smkilani/G-2/LVBackplane/3D/24563131.png

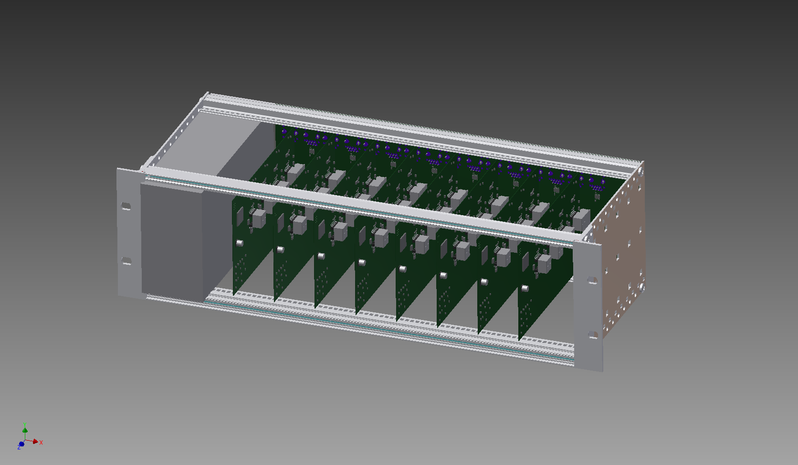
LVBackplane/3D/24563131.png
