smkilani/G-2/PCB - Rack/3d.png

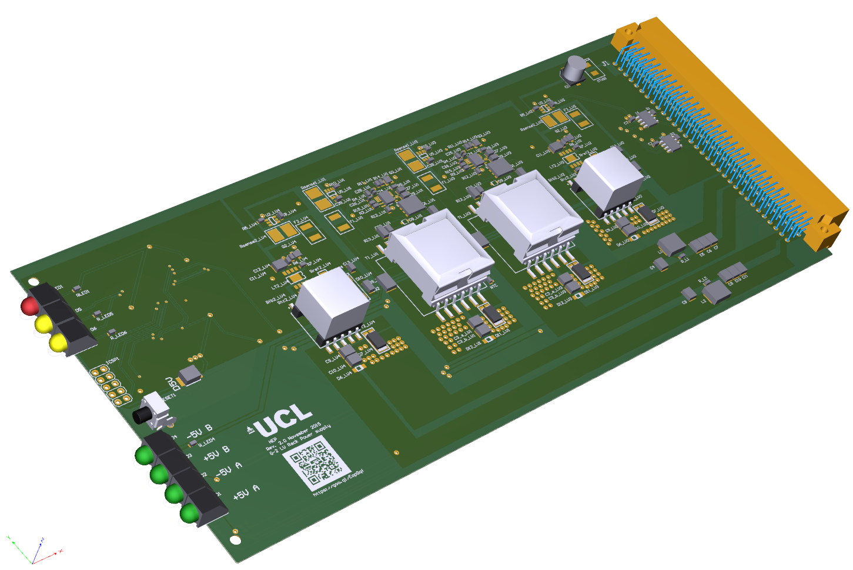
PCB - Rack/3d.png
