smkilani/G-2/PCB - Rack/ATMEL2560ref.png

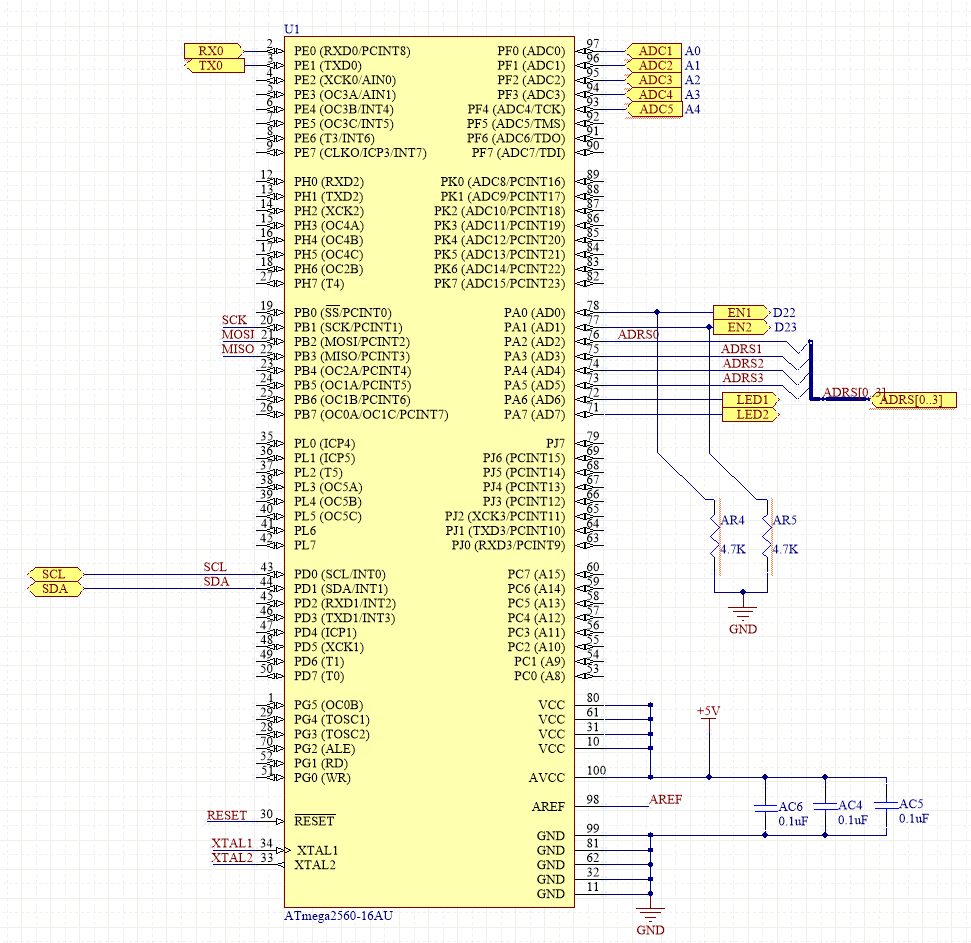
PCB - Rack/ATMEL2560ref.png
