smkilani/G-2/PCB - Rack/BOM2.xls

Designator | Footprint | Quantity | PartNo | Value
C1 | PANASONIC_D | 1 | EMZA500ADA220MF61G | 22uF
C20, C21 | PANASONIC_D | 2 | EEE1EA470WAP | 47uF
D1, D2, D3, D4 | LEDGREEN | 4 | 550-0207F
D5, D6 | LEDYELLOW | 2 | 550-0307F
ICSP1 | 2X03 | 1 | 826953-3
J1 | 09 03 164 6919 | 1
LDO1 | SOT223 | 1 | NCP1117ST50T3G
LED1 | LEDRED | 1 | 550-0407F
LED2 | CHIP-LED0805 | 1 | KPT-2012SGC
LT2_LV1, LT2_LV2, LT2_LV3, LT2_LV4 | S8E | 4 | LT8302ES8E#PBF
RESET1 | 1-1825027-4 | 1 | 1-1825027-4
U1, U2 | SOICN8 | 2 | SP3084EEN-L
U2_LV1, U2_LV2, U2_LV3, U2_LV4 | SOT-23 | 4 | INA138NA/250
Y1 | RESONATOR | 1 | CSTCE16M0V53-R0
U3 | 100A_N | 1 | ATmega2560-16AU
AC1 | 1608[0603] | 1 | CC0603KRX7R9BB104 | 22uF
AC2, AC3, AC4, AC5, AC6, C2, C3, C8_LV1, C8_LV2, C8_LV3, C8_LV4 | 1608[0603] | 11 | CC0603KRX7R9BB104 | 0.1uF
C11_LV1, C11_LV2, C11_LV3, C11_LV4 | C1210 | 4 | UMK325BJ106KM-T | 10uF
C12_LV1, C12_LV2, C12_LV3, C12_LV4 | 1608[0603] | 4 | 06033D105KAT2A | 1uF
C13_LV1, C13_LV2, C13_LV3, C13_LV4 | C0805 | 4 | 08055A221JAT2A | 470p
C30, C31, C32, C33 | 1812 | 4 | C1812C472KDRACTU | 4.7nF
C4, C8, C9_LV1, C9_LV2, C9_LV3, C9_LV4, C10_LV1, C10_LV2, C10_LV3, C10_LV4, C12, C16 | C1210 | 12 | C3225X5R0J107M250AC | 100uF
C5, C6, C7, C9, C10, C11, C13, C14, C15, C17, C18, C19 | C1210 | 12 | CL32A107MPVNNNE | 100uF
Rsense2_LV1, Rsense2_LV2, Rsense2_LV3, Rsense2_LV4 | R6432 | 4 | MCS3264R050FER | 50m
T2_LV1, T2_LV2, T2_LV3, T2_LV4 | EP13 | 4 | 750311457
F2_LV1, F2_LV2, F2_LV3, F2_LV4 | MF-MSMF1 | 4 | MF-MSMF075/24-2
F3 | MF-MSMF1 | 1 | MINISMDC050F-2
L1, L2, L3, L4 | MPLC0730 | 4 | MPLC0730L1R0 | 1uH
Q2_LV1, Q2_LV2, Q2_LV3, Q2_LV4 | SOT-23 | 4 | BSS131
D10_LV1, D10_LV2, D10_LV3, D10_LV4 | DO-214AB | 4 | ES3B
AR2, R6_LV1, R6_LV2, R6_LV3, R6_LV4 | J1-0603 | 5 |  | 1M
NTC | J1-0603 | 1 | NCP18XH103J03RB | 10K
R1, R2 | J1-0603 | 2 |  | 50R
R5_LV1, R5_LV2, R5_LV3, R5_LV4 | J1-0603 | 4 |  | 100k
R7_LV1, R7_LV2, R7_LV3, R7_LV4, Rfb2_LV1, Rfb2_LV2, Rfb2_LV3, Rfb2_LV4 | J1-0603 | 8 |  | 200k
R8_LV1, R8_LV2, R8_LV3, R8_LV4 | C1206 | 4 |  | 100R
RADRS0, RADRS1, RADRS2, RADRS3 | J1-0603 | 4 |  | 47k
RLED1 | J1-0603 | 1 |  | 1k
Rtc2_LV1, Rtc2_LV2, Rtc2_LV3, Rtc2_LV4 | J1-0603 | 4 |  | 169k
R_L1, R_L2, R_L3, R_L4 | J1-0603 | 4 |  | 1R
R_LED1, R_LED2, R_LED3, R_LED4, R_LED5, R_LED6, RLED2 | J1-0603 | 7 |  | 500R
R_NTC, R_pu5, Rref2_LV1, Rref2_LV2, Rref2_LV3, Rref2_LV4 | J1-0603 | 6 |  | 10K
R_pu1, R_pu2, R_pu3, R_pu4 | J1-0603 | 4 |  | 4.7K
D7_LV1, D7_LV2, D7_LV3, D7_LV4 | PDS1040L | 4 | PDS1040L-13
DTVS, DTVS1_LV1, DTVS1_LV2, DTVS1_LV3, DTVS1_LV4 | DO-214AA | 5 | SMBJ24A-E3/52
D6_LV1, D6_LV2, D6_LV3, D6_LV4 | SOD123F | 4 | BZT52H-B5V6
D8_LV1, D8_LV2, D8_LV3, D8_LV4 | DO-214AC | 4 | SMAJ30A
