smkilani/G-2/PCB - MasterController/LVMasterController/Project Outputs for LVMasterController/LVMasterControllerBOM.xlsx

Description | Designator | Footprint | LibRef | PartNo | Quantity | Value
Capacitor (Semiconductor SIM Model) | AC1, AC2, C1, C2, C3, C4, C5, C7, C8, C9, C10, C11, C12, C13, C14 | 1608[0603] | Cap Semi | CC0603KRX7R9BB104 | 15 | 100nF
Capacitor (Semiconductor SIM Model) | C6 | 1608[0603] | Cap Semi | CC0603KRX7R9BB104 | 1 | 33nF
 | D1, D2, D3, D4, D5, D6 | LEDYELLOW | LEDYELLOW | 550-0307F | 6
Power Diode | D7 | SMB-403A | MBRS130LT3G | MBRS130LT3G | 1
TVS | DTVS1 | DO-214AA | SMBJ | SMBJ10CA | 1
Fuse | F1 | MF-MSMF1 | Fuse 1 | MINISMDC050F-2 | 1
MICROCONTROLLER 64/128/256 Kbytes FLASH 4 Kbytes EEPROM 8 Kbytes SRAM 86 General Purpose I/O pins 12-channels16-bit PWM 4 x Serial USARTs 16-channels 10-bit A/D | IC3 | 100A_N | ATMEGA2560AU | ATMEGA2560-16AU | 1
 | ICSP1 | 2X05 | PINHD-2X5 | 2-1761605-3 | 1
 | J1 | 09 03 164 6919 | DIN41612_64WAY | 0903 164 6921 | 1
 | LDO1 | SOT223 | LDO_5V | NCP1117ST50T3G | 1
 | LED1 | LEDRED | LEDRED | 550-0407F | 1
 | P1 | EHHD006A0B41-HZ | DCDCPowerModule | EHHD006A0B41-HZ | 1
POLARIZED CAPACITOR, European symbol | PC1, PC2 | PANASONIC_D | CPOL-EUD | EEE1EA470WAP | 2
Resistor | R1, R2, R10, R11, R12, R13, R14, R17, R_pu1 | J1-0603 | Res3 |  | 9 | 10K
Resistor | R3, R_LED1, R_LED2, R_LED3, R_LED4, R_LED5, R_LED6, Rtrim_down1, Rtrim_up1 | J1-0603 | Res3 |  | 9 | 1K
Resistor | R4, R15 | J1-0603 | Res3 |  | 2 | 1M
Resistor | R5 | J1-0603 | Res3 |  | 1 | 470
Resistor | R6, R7 | J1-0603 | Res3 |  | 2 | 27
Resistor | R8 | J1-0603 | Res3 |  | 1 | 1k5
Resistor | R9 | J1-0603 | Res3 |  | 1 | 4k7
Resistor | R16 | J1-0603 | Res3 |  | 1 | 2k2
 | RESET1 | 1-1825027-4 | PB_RST | 1-1825027-4 | 1
USB UART Asynchronous Serial Data Transfer Chip, 0 to +70 degC, 32-pin LQFP, Pb-Free | U1 | LQFP-32_N | FT232BL | FT232BL | 1
 | U2, U8 | SOP65P640X120-20N | SN74LVC244APWR | SN74LVC244APWR | 2
 | U3, U4, U6, U7 | SOP65P640X120-16N | CD4051BPW | CD4051BPW | 4
 | U9 | SOP8 | SN74LVC2G32DCTR | SN74LVC2G32DCTR | 1
 | U10 | SOIC127P600X175-8N | 93LC46B-I/SN | 93LC46B-I/SN | 1
 | Y1 | RESONATOR | RESONATORMU | CSTCE16M0V53-R0 | 1
 | Y2 | CSTCR6M00G53-R0 | RESONATORMU | CSTCR6M00G53-R0 | 1
