smkilani/G-2/LVBackplane/3D/Imported Components/Backplane2/Backplane2.htm

Autodesk Inventor Translation Report | 26 June 2015 ( 14:19)
Source File: | C:\Users\smkilani\Documents\GitHub\G-2\LVBackplane\3D\Backplane2.step
Translator Type: | STEP | Sending System: | Open CASCADE 6.8
Author: | Author | Translation Time: | 00:00:08
Options
Import Type: | N/A
Entity Types to Import: | Solids, Surfaces, Wires, Points
Import into Repair Environment: | Yes
Import Assembly as Single Part: | No
Create Surfaces As: | Single Composite Feature
Check Parts during Load: | No
Auto Stitch: | No
Enable Advanced Healing: | N/A
+/- | Name | Inventor File | Status
[ ] | Backplane2.iam | C:\Users\smkilani\Documents\GitHub\G-2\LVBackplane\3D\Imported Components\Backplane2\Backplane2.iam | Successful
[ ] | Board.ipt | C:\Users\smkilani\Documents\GitHub\G-2\LVBackplane\3D\Imported Components\Backplane2\Board.ipt | Successful
[ ] | DB1_9.iam | C:\Users\smkilani\Documents\GitHub\G-2\LVBackplane\3D\Imported Components\Backplane2\DB1_9.iam | Successful
[+] [-] | 172-009-212.ipt | C:\Users\smkilani\Documents\GitHub\G-2\LVBackplane\3D\Imported Components\Backplane2\172-009-212.ipt | Warning
Severity | Entity Id | Message
Warning | 98852 | Some Surfaces have been simplified
[ ] | DB2_9.iam | C:\Users\smkilani\Documents\GitHub\G-2\LVBackplane\3D\Imported Components\Backplane2\DB2_9.iam | Successful
[ ] | RJ1_9.iam | C:\Users\smkilani\Documents\GitHub\G-2\LVBackplane\3D\Imported Components\Backplane2\RJ1_9.iam | Successful
[ ] | 424108312.iam | C:\Users\smkilani\Documents\GitHub\G-2\LVBackplane\3D\Imported Components\Backplane2\424108312.iam | Successful
[ ] | Open CASCADE STEP translator 6.8 6.4.1.1.ipt | C:\Users\smkilani\Documents\GitHub\G-2\LVBackplane\3D\Imported Components\Backplane2\Open CASCADE STEP translator 6.8 6.4.1.1.ipt | Successful
[ ] | Open CASCADE STEP translator 6.8 6.4.1.2.ipt | C:\Users\smkilani\Documents\GitHub\G-2\LVBackplane\3D\Imported Components\Backplane2\Open CASCADE STEP translator 6.8 6.4.1.2.ipt | Successful
[ ] | RJ2_9.iam | C:\Users\smkilani\Documents\GitHub\G-2\LVBackplane\3D\Imported Components\Backplane2\RJ2_9.iam | Successful
[ ] | J1_9.iam | C:\Users\smkilani\Documents\GitHub\G-2\LVBackplane\3D\Imported Components\Backplane2\J1_9.iam | Successful
[ ] | EDAC-307-044-520-202.iam | C:\Users\smkilani\Documents\GitHub\G-2\LVBackplane\3D\Imported Components\Backplane2\EDAC-307-044-520-202.iam | Successful
[ ] | EDAC-307-044-520-202_307_Part_.128_Dia_Mounting_Holes.ipt | C:\Users\smkilani\Documents\GitHub\G-2\LVBackplane\3D\Imported Components\Backplane2\EDAC-307-044-520-202_307_Part_.128_Dia_Mounting_Holes.ipt | Successful
[ ] | EDAC-307-044-520-202_307-290-001_520.ipt | C:\Users\smkilani\Documents\GitHub\G-2\LVBackplane\3D\Imported Components\Backplane2\EDAC-307-044-520-202_307-290-001_520.ipt | Successful
[ ] | DB1_8.iam | C:\Users\smkilani\Documents\GitHub\G-2\LVBackplane\3D\Imported Components\Backplane2\DB1_8.iam | Successful
[ ] | DB2_8.iam | C:\Users\smkilani\Documents\GitHub\G-2\LVBackplane\3D\Imported Components\Backplane2\DB2_8.iam | Successful
[ ] | RJ1_8.iam | C:\Users\smkilani\Documents\GitHub\G-2\LVBackplane\3D\Imported Components\Backplane2\RJ1_8.iam | Successful
[ ] | RJ2_8.iam | C:\Users\smkilani\Documents\GitHub\G-2\LVBackplane\3D\Imported Components\Backplane2\RJ2_8.iam | Successful
[ ] | J1_8.iam | C:\Users\smkilani\Documents\GitHub\G-2\LVBackplane\3D\Imported Components\Backplane2\J1_8.iam | Successful
[ ] | DB1_7.iam | C:\Users\smkilani\Documents\GitHub\G-2\LVBackplane\3D\Imported Components\Backplane2\DB1_7.iam | Successful
[ ] | DB2_7.iam | C:\Users\smkilani\Documents\GitHub\G-2\LVBackplane\3D\Imported Components\Backplane2\DB2_7.iam | Successful
[ ] | RJ1_7.iam | C:\Users\smkilani\Documents\GitHub\G-2\LVBackplane\3D\Imported Components\Backplane2\RJ1_7.iam | Successful
[ ] | RJ2_7.iam | C:\Users\smkilani\Documents\GitHub\G-2\LVBackplane\3D\Imported Components\Backplane2\RJ2_7.iam | Successful
[ ] | J1_7.iam | C:\Users\smkilani\Documents\GitHub\G-2\LVBackplane\3D\Imported Components\Backplane2\J1_7.iam | Successful
[ ] | DB1_6.iam | C:\Users\smkilani\Documents\GitHub\G-2\LVBackplane\3D\Imported Components\Backplane2\DB1_6.iam | Successful
[ ] | DB2_6.iam | C:\Users\smkilani\Documents\GitHub\G-2\LVBackplane\3D\Imported Components\Backplane2\DB2_6.iam | Successful
[ ] | RJ1_6.iam | C:\Users\smkilani\Documents\GitHub\G-2\LVBackplane\3D\Imported Components\Backplane2\RJ1_6.iam | Successful
[ ] | RJ2_6.iam | C:\Users\smkilani\Documents\GitHub\G-2\LVBackplane\3D\Imported Components\Backplane2\RJ2_6.iam | Successful
[ ] | J1_6.iam | C:\Users\smkilani\Documents\GitHub\G-2\LVBackplane\3D\Imported Components\Backplane2\J1_6.iam | Successful
[ ] | DB1_5.iam | C:\Users\smkilani\Documents\GitHub\G-2\LVBackplane\3D\Imported Components\Backplane2\DB1_5.iam | Successful
[ ] | DB2_5.iam | C:\Users\smkilani\Documents\GitHub\G-2\LVBackplane\3D\Imported Components\Backplane2\DB2_5.iam | Successful
[ ] | RJ1_5.iam | C:\Users\smkilani\Documents\GitHub\G-2\LVBackplane\3D\Imported Components\Backplane2\RJ1_5.iam | Successful
[ ] | RJ2_5.iam | C:\Users\smkilani\Documents\GitHub\G-2\LVBackplane\3D\Imported Components\Backplane2\RJ2_5.iam | Successful
[ ] | J1_5.iam | C:\Users\smkilani\Documents\GitHub\G-2\LVBackplane\3D\Imported Components\Backplane2\J1_5.iam | Successful
[ ] | DB1_4.iam | C:\Users\smkilani\Documents\GitHub\G-2\LVBackplane\3D\Imported Components\Backplane2\DB1_4.iam | Successful
[ ] | DB2_4.iam | C:\Users\smkilani\Documents\GitHub\G-2\LVBackplane\3D\Imported Components\Backplane2\DB2_4.iam | Successful
[ ] | RJ1_4.iam | C:\Users\smkilani\Documents\GitHub\G-2\LVBackplane\3D\Imported Components\Backplane2\RJ1_4.iam | Successful
[ ] | RJ2_4.iam | C:\Users\smkilani\Documents\GitHub\G-2\LVBackplane\3D\Imported Components\Backplane2\RJ2_4.iam | Successful
[ ] | J1_4.iam | C:\Users\smkilani\Documents\GitHub\G-2\LVBackplane\3D\Imported Components\Backplane2\J1_4.iam | Successful
[ ] | DB1_3.iam | C:\Users\smkilani\Documents\GitHub\G-2\LVBackplane\3D\Imported Components\Backplane2\DB1_3.iam | Successful
[ ] | DB2_3.iam | C:\Users\smkilani\Documents\GitHub\G-2\LVBackplane\3D\Imported Components\Backplane2\DB2_3.iam | Successful
[ ] | RJ1_3.iam | C:\Users\smkilani\Documents\GitHub\G-2\LVBackplane\3D\Imported Components\Backplane2\RJ1_3.iam | Successful
[ ] | RJ2_3.iam | C:\Users\smkilani\Documents\GitHub\G-2\LVBackplane\3D\Imported Components\Backplane2\RJ2_3.iam | Successful
[ ] | J1_3.iam | C:\Users\smkilani\Documents\GitHub\G-2\LVBackplane\3D\Imported Components\Backplane2\J1_3.iam | Successful
[ ] | DB1_2.iam | C:\Users\smkilani\Documents\GitHub\G-2\LVBackplane\3D\Imported Components\Backplane2\DB1_2.iam | Successful
[ ] | DB2_2.iam | C:\Users\smkilani\Documents\GitHub\G-2\LVBackplane\3D\Imported Components\Backplane2\DB2_2.iam | Successful
[ ] | RJ1_2.iam | C:\Users\smkilani\Documents\GitHub\G-2\LVBackplane\3D\Imported Components\Backplane2\RJ1_2.iam | Successful
[ ] | RJ2_2.iam | C:\Users\smkilani\Documents\GitHub\G-2\LVBackplane\3D\Imported Components\Backplane2\RJ2_2.iam | Successful
[ ] | J1_2.iam | C:\Users\smkilani\Documents\GitHub\G-2\LVBackplane\3D\Imported Components\Backplane2\J1_2.iam | Successful
[ ] | DB1_1.iam | C:\Users\smkilani\Documents\GitHub\G-2\LVBackplane\3D\Imported Components\Backplane2\DB1_1.iam | Successful
[ ] | DB2_1.iam | C:\Users\smkilani\Documents\GitHub\G-2\LVBackplane\3D\Imported Components\Backplane2\DB2_1.iam | Successful
[ ] | RJ1_1.iam | C:\Users\smkilani\Documents\GitHub\G-2\LVBackplane\3D\Imported Components\Backplane2\RJ1_1.iam | Successful
[ ] | RJ2_1.iam | C:\Users\smkilani\Documents\GitHub\G-2\LVBackplane\3D\Imported Components\Backplane2\RJ2_1.iam | Successful
[ ] | J1_1.iam | C:\Users\smkilani\Documents\GitHub\G-2\LVBackplane\3D\Imported Components\Backplane2\J1_1.iam | Successful
[ ] | J1.iam | C:\Users\smkilani\Documents\GitHub\G-2\LVBackplane\3D\Imported Components\Backplane2\J1.iam | Successful
[ ] | J1_controller.iam | C:\Users\smkilani\Documents\GitHub\G-2\LVBackplane\3D\Imported Components\Backplane2\J1_controller.iam | Successful
[ ] | RJ2.iam | C:\Users\smkilani\Documents\GitHub\G-2\LVBackplane\3D\Imported Components\Backplane2\RJ2.iam | Successful
[ ] | RJ1.iam | C:\Users\smkilani\Documents\GitHub\G-2\LVBackplane\3D\Imported Components\Backplane2\RJ1.iam | Successful
[ ] | DB2.iam | C:\Users\smkilani\Documents\GitHub\G-2\LVBackplane\3D\Imported Components\Backplane2\DB2.iam | Successful
[ ] | DB1.iam | C:\Users\smkilani\Documents\GitHub\G-2\LVBackplane\3D\Imported Components\Backplane2\DB1.iam | Successful
