smkilani/G-2/LVBackplane/3D/Imported Components/LV1/LV1.htm

Autodesk Inventor Translation Report | 26 June 2015 ( 16:13)
Source File: | C:\Users\smkilani\Documents\GitHub\G-2\LVBackplane\3D\LV1.step
Translator Type: | STEP | Sending System: | Open CASCADE 6.8
Author: | Author | Translation Time: | 00:00:05
Options
Import Type: | N/A
Entity Types to Import: | Solids, Surfaces, Wires, Points
Import into Repair Environment: | Yes
Import Assembly as Single Part: | No
Create Surfaces As: | Single Composite Feature
Check Parts during Load: | No
Auto Stitch: | No
Enable Advanced Healing: | N/A
+/- | Name | Inventor File | Status
[ ] | LV1.iam | C:\Users\smkilani\Documents\GitHub\G-2\LVBackplane\3D\Imported Components\LV1\LV1.iam | Successful
[ ] | Board.ipt | C:\Users\smkilani\Documents\GitHub\G-2\LVBackplane\3D\Imported Components\LV1\Board.ipt | Successful
[ ] | U2.iam | C:\Users\smkilani\Documents\GitHub\G-2\LVBackplane\3D\Imported Components\LV1\U2.iam | Successful
[ ] | 574394112.iam | C:\Users\smkilani\Documents\GitHub\G-2\LVBackplane\3D\Imported Components\LV1\574394112.iam | Successful
[ ] | Extruded.ipt | C:\Users\smkilani\Documents\GitHub\G-2\LVBackplane\3D\Imported Components\LV1\Extruded.ipt | Successful
[ ] | 574394272.iam | C:\Users\smkilani\Documents\GitHub\G-2\LVBackplane\3D\Imported Components\LV1\574394272.iam | Successful
[ ] | Extruded_1.ipt | C:\Users\smkilani\Documents\GitHub\G-2\LVBackplane\3D\Imported Components\LV1\Extruded_1.ipt | Successful
[ ] | U1.iam | C:\Users\smkilani\Documents\GitHub\G-2\LVBackplane\3D\Imported Components\LV1\U1.iam | Successful
[ ] | R2.iam | C:\Users\smkilani\Documents\GitHub\G-2\LVBackplane\3D\Imported Components\LV1\R2.iam | Successful
[ ] | 574386432.iam | C:\Users\smkilani\Documents\GitHub\G-2\LVBackplane\3D\Imported Components\LV1\574386432.iam | Successful
[ ] | Extruded_2.ipt | C:\Users\smkilani\Documents\GitHub\G-2\LVBackplane\3D\Imported Components\LV1\Extruded_2.ipt | Successful
[ ] | R1.iam | C:\Users\smkilani\Documents\GitHub\G-2\LVBackplane\3D\Imported Components\LV1\R1.iam | Successful
[ ] | C3.iam | C:\Users\smkilani\Documents\GitHub\G-2\LVBackplane\3D\Imported Components\LV1\C3.iam | Successful
[ ] | 574386752.iam | C:\Users\smkilani\Documents\GitHub\G-2\LVBackplane\3D\Imported Components\LV1\574386752.iam | Successful
[ ] | Extruded_3.ipt | C:\Users\smkilani\Documents\GitHub\G-2\LVBackplane\3D\Imported Components\LV1\Extruded_3.ipt | Successful
[ ] | C2.iam | C:\Users\smkilani\Documents\GitHub\G-2\LVBackplane\3D\Imported Components\LV1\C2.iam | Successful
[ ] | U_.iam | C:\Users\smkilani\Documents\GitHub\G-2\LVBackplane\3D\Imported Components\LV1\U_.iam | Successful
[ ] | 853979200.iam | C:\Users\smkilani\Documents\GitHub\G-2\LVBackplane\3D\Imported Components\LV1\853979200.iam | Successful
[ ] | Extruded_4.ipt | C:\Users\smkilani\Documents\GitHub\G-2\LVBackplane\3D\Imported Components\LV1\Extruded_4.ipt | Successful
[ ] | RLED2.iam | C:\Users\smkilani\Documents\GitHub\G-2\LVBackplane\3D\Imported Components\LV1\RLED2.iam | Successful
[ ] | 574386272.iam | C:\Users\smkilani\Documents\GitHub\G-2\LVBackplane\3D\Imported Components\LV1\574386272.iam | Successful
[ ] | Extruded_5.ipt | C:\Users\smkilani\Documents\GitHub\G-2\LVBackplane\3D\Imported Components\LV1\Extruded_5.ipt | Successful
[ ] | RLED1.iam | C:\Users\smkilani\Documents\GitHub\G-2\LVBackplane\3D\Imported Components\LV1\RLED1.iam | Successful
[ ] | R_pu4.iam | C:\Users\smkilani\Documents\GitHub\G-2\LVBackplane\3D\Imported Components\LV1\R_pu4.iam | Successful
[ ] | R_pu3.iam | C:\Users\smkilani\Documents\GitHub\G-2\LVBackplane\3D\Imported Components\LV1\R_pu3.iam | Successful
[ ] | R_pu2.iam | C:\Users\smkilani\Documents\GitHub\G-2\LVBackplane\3D\Imported Components\LV1\R_pu2.iam | Successful
[ ] | R_pu1.iam | C:\Users\smkilani\Documents\GitHub\G-2\LVBackplane\3D\Imported Components\LV1\R_pu1.iam | Successful
[ ] | R_NTC.iam | C:\Users\smkilani\Documents\GitHub\G-2\LVBackplane\3D\Imported Components\LV1\R_NTC.iam | Successful
[ ] | NTC.iam | C:\Users\smkilani\Documents\GitHub\G-2\LVBackplane\3D\Imported Components\LV1\NTC.iam | Successful
[ ] | C1.iam | C:\Users\smkilani\Documents\GitHub\G-2\LVBackplane\3D\Imported Components\LV1\C1.iam | Successful
[ ] | 578375272.iam | C:\Users\smkilani\Documents\GitHub\G-2\LVBackplane\3D\Imported Components\LV1\578375272.iam | Successful
[ ] | Cylinder.ipt | C:\Users\smkilani\Documents\GitHub\G-2\LVBackplane\3D\Imported Components\LV1\Cylinder.ipt | Successful
[ ] | 574395072.iam | C:\Users\smkilani\Documents\GitHub\G-2\LVBackplane\3D\Imported Components\LV1\574395072.iam | Successful
[ ] | Extruded_6.ipt | C:\Users\smkilani\Documents\GitHub\G-2\LVBackplane\3D\Imported Components\LV1\Extruded_6.ipt | Successful
[ ] | AR2.iam | C:\Users\smkilani\Documents\GitHub\G-2\LVBackplane\3D\Imported Components\LV1\AR2.iam | Successful
[ ] | AC5.iam | C:\Users\smkilani\Documents\GitHub\G-2\LVBackplane\3D\Imported Components\LV1\AC5.iam | Successful
[ ] | 574387872.iam | C:\Users\smkilani\Documents\GitHub\G-2\LVBackplane\3D\Imported Components\LV1\574387872.iam | Successful
[ ] | Extruded_7.ipt | C:\Users\smkilani\Documents\GitHub\G-2\LVBackplane\3D\Imported Components\LV1\Extruded_7.ipt | Successful
[ ] | AC4.iam | C:\Users\smkilani\Documents\GitHub\G-2\LVBackplane\3D\Imported Components\LV1\AC4.iam | Successful
[ ] | AC3.iam | C:\Users\smkilani\Documents\GitHub\G-2\LVBackplane\3D\Imported Components\LV1\AC3.iam | Successful
[ ] | AC2.iam | C:\Users\smkilani\Documents\GitHub\G-2\LVBackplane\3D\Imported Components\LV1\AC2.iam | Successful
[ ] | AC1.iam | C:\Users\smkilani\Documents\GitHub\G-2\LVBackplane\3D\Imported Components\LV1\AC1.iam | Successful
[ ] | C11_LV4.iam | C:\Users\smkilani\Documents\GitHub\G-2\LVBackplane\3D\Imported Components\LV1\C11_LV4.iam | Successful
[ ] | 574393952.iam | C:\Users\smkilani\Documents\GitHub\G-2\LVBackplane\3D\Imported Components\LV1\574393952.iam | Successful
[ ] | Extruded_8.ipt | C:\Users\smkilani\Documents\GitHub\G-2\LVBackplane\3D\Imported Components\LV1\Extruded_8.ipt | Successful
[ ] | Rtc2_LV4.iam | C:\Users\smkilani\Documents\GitHub\G-2\LVBackplane\3D\Imported Components\LV1\Rtc2_LV4.iam | Successful
[ ] | R7_LV4.iam | C:\Users\smkilani\Documents\GitHub\G-2\LVBackplane\3D\Imported Components\LV1\R7_LV4.iam | Successful
[ ] | R6_LV4.iam | C:\Users\smkilani\Documents\GitHub\G-2\LVBackplane\3D\Imported Components\LV1\R6_LV4.iam | Successful
[ ] | Q2_LV4.iam | C:\Users\smkilani\Documents\GitHub\G-2\LVBackplane\3D\Imported Components\LV1\Q2_LV4.iam | Successful
[ ] | 923694272.iam | C:\Users\smkilani\Documents\GitHub\G-2\LVBackplane\3D\Imported Components\LV1\923694272.iam | Successful
[ ] | Extruded_9.ipt | C:\Users\smkilani\Documents\GitHub\G-2\LVBackplane\3D\Imported Components\LV1\Extruded_9.ipt | Successful
[ ] | R8_LV4.iam | C:\Users\smkilani\Documents\GitHub\G-2\LVBackplane\3D\Imported Components\LV1\R8_LV4.iam | Successful
[ ] | 923694912.iam | C:\Users\smkilani\Documents\GitHub\G-2\LVBackplane\3D\Imported Components\LV1\923694912.iam | Successful
[ ] | Extruded_10.ipt | C:\Users\smkilani\Documents\GitHub\G-2\LVBackplane\3D\Imported Components\LV1\Extruded_10.ipt | Successful
[ ] | C30_LV4.iam | C:\Users\smkilani\Documents\GitHub\G-2\LVBackplane\3D\Imported Components\LV1\C30_LV4.iam | Successful
[ ] | 923695072.iam | C:\Users\smkilani\Documents\GitHub\G-2\LVBackplane\3D\Imported Components\LV1\923695072.iam | Successful
[ ] | Extruded_11.ipt | C:\Users\smkilani\Documents\GitHub\G-2\LVBackplane\3D\Imported Components\LV1\Extruded_11.ipt | Successful
[ ] | T2_LV4.iam | C:\Users\smkilani\Documents\GitHub\G-2\LVBackplane\3D\Imported Components\LV1\T2_LV4.iam | Successful
[ ] | WE-FB_EP13.iam | C:\Users\smkilani\Documents\GitHub\G-2\LVBackplane\3D\Imported Components\LV1\WE-FB_EP13.iam | Successful
[ ] | Gehäuse.ipt | C:\Users\smkilani\Documents\GitHub\G-2\LVBackplane\3D\Imported Components\LV1\Gehäuse.ipt | Successful
[ ] | Core_EP-13.ipt | C:\Users\smkilani\Documents\GitHub\G-2\LVBackplane\3D\Imported Components\LV1\Core_EP-13.ipt | Successful
[ ] | C9_LV4.iam | C:\Users\smkilani\Documents\GitHub\G-2\LVBackplane\3D\Imported Components\LV1\C9_LV4.iam | Successful
[ ] | Rref2_LV4.iam | C:\Users\smkilani\Documents\GitHub\G-2\LVBackplane\3D\Imported Components\LV1\Rref2_LV4.iam | Successful
[ ] | R5_LV4.iam | C:\Users\smkilani\Documents\GitHub\G-2\LVBackplane\3D\Imported Components\LV1\R5_LV4.iam | Successful
[ ] | D7_LV4.iam | C:\Users\smkilani\Documents\GitHub\G-2\LVBackplane\3D\Imported Components\LV1\D7_LV4.iam | Successful
[ ] | 574394592.iam | C:\Users\smkilani\Documents\GitHub\G-2\LVBackplane\3D\Imported Components\LV1\574394592.iam | Successful
[ ] | Extruded_12.ipt | C:\Users\smkilani\Documents\GitHub\G-2\LVBackplane\3D\Imported Components\LV1\Extruded_12.ipt | Successful
[ ] | 574394752.iam | C:\Users\smkilani\Documents\GitHub\G-2\LVBackplane\3D\Imported Components\LV1\574394752.iam | Successful
[ ] | Extruded_13.ipt | C:\Users\smkilani\Documents\GitHub\G-2\LVBackplane\3D\Imported Components\LV1\Extruded_13.ipt | Successful
[ ] | 574394912.iam | C:\Users\smkilani\Documents\GitHub\G-2\LVBackplane\3D\Imported Components\LV1\574394912.iam | Successful
[ ] | Extruded_14.ipt | C:\Users\smkilani\Documents\GitHub\G-2\LVBackplane\3D\Imported Components\LV1\Extruded_14.ipt | Successful
[ ] | C13_LV4.iam | C:\Users\smkilani\Documents\GitHub\G-2\LVBackplane\3D\Imported Components\LV1\C13_LV4.iam | Successful
[ ] | 923695392.iam | C:\Users\smkilani\Documents\GitHub\G-2\LVBackplane\3D\Imported Components\LV1\923695392.iam | Successful
[ ] | Extruded_15.ipt | C:\Users\smkilani\Documents\GitHub\G-2\LVBackplane\3D\Imported Components\LV1\Extruded_15.ipt | Successful
[ ] | C10_LV4.iam | C:\Users\smkilani\Documents\GitHub\G-2\LVBackplane\3D\Imported Components\LV1\C10_LV4.iam | Successful
[ ] | Rfb2_LV4.iam | C:\Users\smkilani\Documents\GitHub\G-2\LVBackplane\3D\Imported Components\LV1\Rfb2_LV4.iam | Successful
[ ] | C12_LV4.iam | C:\Users\smkilani\Documents\GitHub\G-2\LVBackplane\3D\Imported Components\LV1\C12_LV4.iam | Successful
[ ] | C8_LV4.iam | C:\Users\smkilani\Documents\GitHub\G-2\LVBackplane\3D\Imported Components\LV1\C8_LV4.iam | Successful
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
[ ] | C12_LV1.iam | C:\Users\smkilani\Documents\GitHub\G-2\LVBackplane\3D\Imported Components\LV1\C12_LV1.iam | Successful
[ ] | Rfb2_LV1.iam | C:\Users\smkilani\Documents\GitHub\G-2\LVBackplane\3D\Imported Components\LV1\Rfb2_LV1.iam | Successful
[ ] | C10_LV1.iam | C:\Users\smkilani\Documents\GitHub\G-2\LVBackplane\3D\Imported Components\LV1\C10_LV1.iam | Successful
[ ] | C13_LV1.iam | C:\Users\smkilani\Documents\GitHub\G-2\LVBackplane\3D\Imported Components\LV1\C13_LV1.iam | Successful
[ ] | D7_LV1.iam | C:\Users\smkilani\Documents\GitHub\G-2\LVBackplane\3D\Imported Components\LV1\D7_LV1.iam | Successful
[ ] | R5_LV1.iam | C:\Users\smkilani\Documents\GitHub\G-2\LVBackplane\3D\Imported Components\LV1\R5_LV1.iam | Successful
[ ] | Rref2_LV1.iam | C:\Users\smkilani\Documents\GitHub\G-2\LVBackplane\3D\Imported Components\LV1\Rref2_LV1.iam | Successful
[ ] | C9_LV1.iam | C:\Users\smkilani\Documents\GitHub\G-2\LVBackplane\3D\Imported Components\LV1\C9_LV1.iam | Successful
[ ] | T2_LV1.iam | C:\Users\smkilani\Documents\GitHub\G-2\LVBackplane\3D\Imported Components\LV1\T2_LV1.iam | Successful
[ ] | C30_LV1.iam | C:\Users\smkilani\Documents\GitHub\G-2\LVBackplane\3D\Imported Components\LV1\C30_LV1.iam | Successful
[ ] | R8_LV1.iam | C:\Users\smkilani\Documents\GitHub\G-2\LVBackplane\3D\Imported Components\LV1\R8_LV1.iam | Successful
[ ] | Q2_LV1.iam | C:\Users\smkilani\Documents\GitHub\G-2\LVBackplane\3D\Imported Components\LV1\Q2_LV1.iam | Successful
[ ] | R6_LV1.iam | C:\Users\smkilani\Documents\GitHub\G-2\LVBackplane\3D\Imported Components\LV1\R6_LV1.iam | Successful
[ ] | R7_LV1.iam | C:\Users\smkilani\Documents\GitHub\G-2\LVBackplane\3D\Imported Components\LV1\R7_LV1.iam | Successful
[ ] | Rtc2_LV1.iam | C:\Users\smkilani\Documents\GitHub\G-2\LVBackplane\3D\Imported Components\LV1\Rtc2_LV1.iam | Successful
[ ] | C11_LV1.iam | C:\Users\smkilani\Documents\GitHub\G-2\LVBackplane\3D\Imported Components\LV1\C11_LV1.iam | Successful
