smkilani/G-2/LVBackplane/3D/Imported Components/Backplane/Backplane.htm

Autodesk Inventor Translation Report | 23 June 2015 ( 15:08)
Source File: | C:\Users\smkilani\Documents\GitHub\G-2\LVBackplane\3D\Backplane.step
Translator Type: | STEP | Sending System: | Open CASCADE 6.8
Author: | Author | Translation Time: | 00:00:09
Options
Import Type: | N/A
Entity Types to Import: | Solids, Surfaces, Wires, Points
Import into Repair Environment: | Yes
Import Assembly as Single Part: | No
Create Surfaces As: | Single Composite Feature
Check Parts during Load: | No
Auto Stitch: | No
Enable Advanced Healing: | N/A
+/- | Name | Inventor File | Status
[ ] | Backplane.iam | C:\Users\smkilani\Documents\GitHub\G-2\LVBackplane\3D\Imported Components\Backplane\Backplane.iam | Successful
[ ] | Board.ipt | C:\Users\smkilani\Documents\GitHub\G-2\LVBackplane\3D\Imported Components\Backplane\Board.ipt | Successful
[ ] | U2_U8.iam | C:\Users\smkilani\Documents\GitHub\G-2\LVBackplane\3D\Imported Components\Backplane\U2_U8.iam | Successful
[ ] | 574400032.iam | C:\Users\smkilani\Documents\GitHub\G-2\LVBackplane\3D\Imported Components\Backplane\574400032.iam | Successful
[ ] | Extruded.ipt | C:\Users\smkilani\Documents\GitHub\G-2\LVBackplane\3D\Imported Components\Backplane\Extruded.ipt | Successful
[ ] | 574400192.iam | C:\Users\smkilani\Documents\GitHub\G-2\LVBackplane\3D\Imported Components\Backplane\574400192.iam | Successful
[ ] | Extruded_1.ipt | C:\Users\smkilani\Documents\GitHub\G-2\LVBackplane\3D\Imported Components\Backplane\Extruded_1.ipt | Successful
[ ] | U1_U8.iam | C:\Users\smkilani\Documents\GitHub\G-2\LVBackplane\3D\Imported Components\Backplane\U1_U8.iam | Successful
[ ] | RJ2_U8.iam | C:\Users\smkilani\Documents\GitHub\G-2\LVBackplane\3D\Imported Components\Backplane\RJ2_U8.iam | Successful
[ ] | 424108312.iam | C:\Users\smkilani\Documents\GitHub\G-2\LVBackplane\3D\Imported Components\Backplane\424108312.iam | Successful
[ ] | Open CASCADE STEP translator 6.8 4.4.1.1.ipt | C:\Users\smkilani\Documents\GitHub\G-2\LVBackplane\3D\Imported Components\Backplane\Open CASCADE STEP translator 6.8 4.4.1.1.ipt | Successful
[ ] | Open CASCADE STEP translator 6.8 4.4.1.2.ipt | C:\Users\smkilani\Documents\GitHub\G-2\LVBackplane\3D\Imported Components\Backplane\Open CASCADE STEP translator 6.8 4.4.1.2.ipt | Successful
[ ] | RJ1_U8.iam | C:\Users\smkilani\Documents\GitHub\G-2\LVBackplane\3D\Imported Components\Backplane\RJ1_U8.iam | Successful
[ ] | R2_U8.iam | C:\Users\smkilani\Documents\GitHub\G-2\LVBackplane\3D\Imported Components\Backplane\R2_U8.iam | Successful
[ ] | 574386432.iam | C:\Users\smkilani\Documents\GitHub\G-2\LVBackplane\3D\Imported Components\Backplane\574386432.iam | Successful
[ ] | Extruded_2.ipt | C:\Users\smkilani\Documents\GitHub\G-2\LVBackplane\3D\Imported Components\Backplane\Extruded_2.ipt | Successful
[ ] | R1_U8.iam | C:\Users\smkilani\Documents\GitHub\G-2\LVBackplane\3D\Imported Components\Backplane\R1_U8.iam | Successful
[ ] | DB2_U8.iam | C:\Users\smkilani\Documents\GitHub\G-2\LVBackplane\3D\Imported Components\Backplane\DB2_U8.iam | Successful
[+] [-] | 172-009-212.ipt | C:\Users\smkilani\Documents\GitHub\G-2\LVBackplane\3D\Imported Components\Backplane\172-009-212.ipt | Warning
Severity | Entity Id | Message
Warning | 104482 | Some Surfaces have been simplified
[ ] | DB1_U8.iam | C:\Users\smkilani\Documents\GitHub\G-2\LVBackplane\3D\Imported Components\Backplane\DB1_U8.iam | Successful
[ ] | C2_U8.iam | C:\Users\smkilani\Documents\GitHub\G-2\LVBackplane\3D\Imported Components\Backplane\C2_U8.iam | Successful
[ ] | 574387872.iam | C:\Users\smkilani\Documents\GitHub\G-2\LVBackplane\3D\Imported Components\Backplane\574387872.iam | Successful
[ ] | Extruded_3.ipt | C:\Users\smkilani\Documents\GitHub\G-2\LVBackplane\3D\Imported Components\Backplane\Extruded_3.ipt | Successful
[ ] | C1_U8.iam | C:\Users\smkilani\Documents\GitHub\G-2\LVBackplane\3D\Imported Components\Backplane\C1_U8.iam | Successful
[ ] | J1_U8.iam | C:\Users\smkilani\Documents\GitHub\G-2\LVBackplane\3D\Imported Components\Backplane\J1_U8.iam | Successful
[ ] | 10046971004lf.ipt | C:\Users\smkilani\Documents\GitHub\G-2\LVBackplane\3D\Imported Components\Backplane\10046971004lf.ipt | Successful
[ ] | J1_U5.iam | C:\Users\smkilani\Documents\GitHub\G-2\LVBackplane\3D\Imported Components\Backplane\J1_U5.iam | Successful
[ ] | C1_U5.iam | C:\Users\smkilani\Documents\GitHub\G-2\LVBackplane\3D\Imported Components\Backplane\C1_U5.iam | Successful
[ ] | C2_U5.iam | C:\Users\smkilani\Documents\GitHub\G-2\LVBackplane\3D\Imported Components\Backplane\C2_U5.iam | Successful
[ ] | DB1_U5.iam | C:\Users\smkilani\Documents\GitHub\G-2\LVBackplane\3D\Imported Components\Backplane\DB1_U5.iam | Successful
[ ] | DB2_U5.iam | C:\Users\smkilani\Documents\GitHub\G-2\LVBackplane\3D\Imported Components\Backplane\DB2_U5.iam | Successful
[ ] | R1_U5.iam | C:\Users\smkilani\Documents\GitHub\G-2\LVBackplane\3D\Imported Components\Backplane\R1_U5.iam | Successful
[ ] | R2_U5.iam | C:\Users\smkilani\Documents\GitHub\G-2\LVBackplane\3D\Imported Components\Backplane\R2_U5.iam | Successful
[ ] | RJ1_U5.iam | C:\Users\smkilani\Documents\GitHub\G-2\LVBackplane\3D\Imported Components\Backplane\RJ1_U5.iam | Successful
[ ] | RJ2_U5.iam | C:\Users\smkilani\Documents\GitHub\G-2\LVBackplane\3D\Imported Components\Backplane\RJ2_U5.iam | Successful
[ ] | U1_U5.iam | C:\Users\smkilani\Documents\GitHub\G-2\LVBackplane\3D\Imported Components\Backplane\U1_U5.iam | Successful
[ ] | U2_U5.iam | C:\Users\smkilani\Documents\GitHub\G-2\LVBackplane\3D\Imported Components\Backplane\U2_U5.iam | Successful
[ ] | U2_U7.iam | C:\Users\smkilani\Documents\GitHub\G-2\LVBackplane\3D\Imported Components\Backplane\U2_U7.iam | Successful
[ ] | U1_U7.iam | C:\Users\smkilani\Documents\GitHub\G-2\LVBackplane\3D\Imported Components\Backplane\U1_U7.iam | Successful
[ ] | RJ2_U7.iam | C:\Users\smkilani\Documents\GitHub\G-2\LVBackplane\3D\Imported Components\Backplane\RJ2_U7.iam | Successful
[ ] | RJ1_U7.iam | C:\Users\smkilani\Documents\GitHub\G-2\LVBackplane\3D\Imported Components\Backplane\RJ1_U7.iam | Successful
[ ] | R2_U7.iam | C:\Users\smkilani\Documents\GitHub\G-2\LVBackplane\3D\Imported Components\Backplane\R2_U7.iam | Successful
[ ] | R1_U7.iam | C:\Users\smkilani\Documents\GitHub\G-2\LVBackplane\3D\Imported Components\Backplane\R1_U7.iam | Successful
[ ] | DB2_U7.iam | C:\Users\smkilani\Documents\GitHub\G-2\LVBackplane\3D\Imported Components\Backplane\DB2_U7.iam | Successful
[ ] | DB1_U7.iam | C:\Users\smkilani\Documents\GitHub\G-2\LVBackplane\3D\Imported Components\Backplane\DB1_U7.iam | Successful
[ ] | C2_U7.iam | C:\Users\smkilani\Documents\GitHub\G-2\LVBackplane\3D\Imported Components\Backplane\C2_U7.iam | Successful
[ ] | C1_U7.iam | C:\Users\smkilani\Documents\GitHub\G-2\LVBackplane\3D\Imported Components\Backplane\C1_U7.iam | Successful
[ ] | J1_U7.iam | C:\Users\smkilani\Documents\GitHub\G-2\LVBackplane\3D\Imported Components\Backplane\J1_U7.iam | Successful
[ ] | J1_U4.iam | C:\Users\smkilani\Documents\GitHub\G-2\LVBackplane\3D\Imported Components\Backplane\J1_U4.iam | Successful
[ ] | C1_U4.iam | C:\Users\smkilani\Documents\GitHub\G-2\LVBackplane\3D\Imported Components\Backplane\C1_U4.iam | Successful
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
[ ] | U1_U1.iam | C:\Users\smkilani\Documents\GitHub\G-2\LVBackplane\3D\Imported Components\Backplane\U1_U1.iam | Successful
[ ] | U2_U1.iam | C:\Users\smkilani\Documents\GitHub\G-2\LVBackplane\3D\Imported Components\Backplane\U2_U1.iam | Successful
