smkilani/G-2/PCB - Rack 2/Project Outputs for G2_LV/G2_LV_2.xlsx

Designator | Footprint | Quantity | PartNo | Value | Required | Stock | Ordered | Column1
D1 | SMB-403A | 1 | MBRS130LT3G |  | 60 |  | 70
D11, D12, D13, D14 | LEDGREEN | 4 | 550-0207F |  | 240 |  | 200
D2_A, D2_B, D2_C, D2_D | DO-214AC | 4 | SMAJ30A |  | 240 |  | 250
D3_A, D3_B, D3_C, D3_D | PDS1040L | 4 | SBR15U50SP5-13 |  | 240 |  | 240
D4_A, D4_B, D4_C, D4_D | SOD123F | 4 | BZT52H-B5V6 |  | 240 |  | 200
D5_A, D5_B, D5_C, D5_D | DO-214AB | 4 | ES3B |  | 240 |  | 200
D9, D10 | LEDYELLOW | 2 | 550-0307F |  | 120 |  | 120
DTVS1 | DO-214AA | 1 | SMBJ10CA |  | 60
DTVS2 | SMBJ | 1 | SMBJ36A |  | 60
F1 | MF-MSMF1 | 1 | MINISMDC050F-2 |  | 60 |  | 60
F2_A, F2_B, F2_C, F2_D | MC33192 | 4 | MC33192 |  | 240 |  | 250
ICSP1 | 2X05 | 1 | 2-1761605-3 |  | 60
J1 | 09 03 164 6919 | 1 | 0903 164 6921 |  | 60
L5, L6, L7, L8 | ACMV_TDK | 4 | ACM90V-701-2PL |  | 240 |  | 240
LDO1 | SOT223 | 1 | NCP1117ST50T3G |  | 60 |  | 60
LED1 | CHIP-LED0805 | 1 | KPT-2012SGC |  | 60 |  | 100
LED2 | LEDRED | 1 | 550-0407F |  | 60
LT1_A, LT1_B, LT1_C, LT1_D | S8E | 4 | LT8302ES8E#PBF |  | 240 |  | 240
RESET1 | 1-1825027-4 | 1 | 1-1825027-4 |  | 60 |  | 30
SSR1, SSR2 | LCA701S | 2 | LCA701S |  | 120
T1_A, T1_B, T1_C, T1_D | EP13 | 4 | 750311457 |  | 240
U2_A, U2_B, U2_C, U2_D | SOT-23 | 4 | INA138NA/250 |  | 240 |  | 23
U3 | 32A_N | 1 | ATmega328P-AU |  | 60 |  | 60
U5, U6 | SOICN8 | 2 | ADM4855ARZ |  | 120 |  | 20
Y1 | RESONATOR | 1 | CSTCE16M0V53-R0 |  | 60 |  | 60
AC1, AC2, AC3, AC4, C3_A, C3_B, C3_C, C3_D, C25, C26 | 1608[0603] | 10 | CC0603KRX7R9BB104 | 0.1uF | 600 |  | 600
AR2, AR6 | J1-0603 | 2 |  | 1K | 120 |  | 500
AR1 | J1-0603 | 1 |  | 1M | 60 |  | 200
R24, R25, R26, R31 | J1-0603 | 4 |  | 1R | 240 |  | 300
C11_A, C11_B, C11_C, C11_D | 1608[0603] | 4 | 06033D105KAT2A | 1uF | 240 |  | 240
L1, L2, L3, L4 | MPLC0730 | 4 | MPLC0730L1R0 | 1uH | 240 |  | 240
C6_A, C6_B, C6_C, C6_D, C7_A, C7_B, C7_C, C7_D, C8_A, C8_B, C8_C, C8_D | C1210 | 12 | C1210C225K1RACTU | 2.2uF | 720 |  | 200
AR4, AR5 | J1-0603 | 2 |  | 4.7K | 120 |  | 200
C39, C45, C46, C47, C48, C49, C50, C51 | 1812 | 8 | C1812C472KDRACTU | 4.7nF | 480 |  | 200
AR3, R29, Rref1_A, Rref1_B, Rref1_C, Rref1_D | J1-0603 | 6 |  | 10k | 360 |  | 500 | order
NTC1 | J1-0603 | 1 | NCP18XH103J03RB | 10K | 60 |  | 60
C4_A, C4_B, C4_C, C4_D | C1210 | 4 | GRM32ER61H106KA12L | 10uF | 240 |  | 250
R5_A, R5_B, R5_C, R5_D | J1-0603 | 4 |  | 15k | 240 |  | 300
R18, R19, R20, R21 | J1-0603 | 4 |  | 47k | 240 |  | 300
C1, C2 | PANASONIC_D | 2 | EEE1EA470WAP | 47uF | 120 |  | 120
R2_A, R2_B, R2_C, R2_D | R6432 | 4 | MCS3264R050FER | 50m | 240 |  | 200
R22, R23 | J1-0603 | 2 |  | 50R | 120 |  | 200
R1_A, R1_B, R1_C, R1_D | J1-0603 | 4 |  | 100k | 240 |  | 300
R4_A, R4_B, R4_C, R4_D | C1206 | 4 | CRS1206-FX-1000ELF | 100R | 240 |  | 200
C27, C28, C29, C31, C32, C33, C35, C36, C37, C41, C42, C43 | C1210 | 12 | CL32A107MPVNNNE | 100uF | 720
C40 | EMVY101ARA101MKE0S | 1 | EMVY101ARA101MKE0S | 100uF | 60
C9_A, C9_B, C9_C, C9_D, C10_A, C10_B, C10_C, C10_D, C30, C34, C38, C44 | C1210 | 12 | C3225X5R0J107M250AC | 100uF | 720
Rtc1_A, Rtc1_B, Rtc1_C, Rtc1_D | J1-0603 | 4 |  | 169k | 240 |  | 500
Rfb1_A, Rfb1_B, Rfb1_C, Rfb1_D | J1-0603 | 4 |  | 200k | 240 |  | 300
R3_A, R3_B, R3_C, R3_D | J1-0603 | 4 |  | 390k | 240
C5_A, C5_B, C5_C, C5_D | C0805 | 4 | 08055A221JAT2A | 470p | 240 |  | 250
R27, R28, R30, R32, R33, R34 | J1-0603 | 6 |  | 500R | 360
