smkilani/G-2/PCB - Rack/Project Outputs for G2_LV/G2_LV3.xlsx

Old Designator | Designator | Footprint | Quantity | PartNo | Value | Total needed | Stock
D5V | D1 | SMB-403A | 1 | MBRS130LT3G |  | 3
D1, D2, D3, D4 | D11, D12, D13, D14 | LEDGREEN | 4 | 550-0207F |  | 12
D8_LV2, D8_LV4 | D2_A, D2_D | DO-214AC | 2 | SMAJ30A |  | 6
D7_LV2, D7_LV4, D11_LV1, D11_LV3 | D3_A, D3_D, D7_B, D7_C | PDS1040L | 4 | PDS760-13 |  | 12
D6_LV2, D6_LV4, D12_LV1, D12_LV3 | D4_A, D4_D, D8_B, D8_C | SOD123F | 4 | BZT52H-B5V6 |  | 12
D10_LV2, D10_LV4 | D5_A, D5_D | DO-214AB | 2 | ES3B |  | 6
D9_LV1, D9_LV3 | D6_B, D6_C | SOD-323 | 2 | BAV20WS |  | 6
D5, D6 | D9, D10 | LEDYELLOW | 2 | 550-0307F |  | 6
DTVS | DTVS1 | DO-214AA | 1 | SMBJ12CA |  | 3
DTVS1 | DTVS2 | DO-214AA | 1 | SMBJ36A |  | 3
F1_LV1, F1_LV3, F2_LV2, F2_LV4, F3 | F1, F2_A, F2_D, F3_B, F3_C | MF-MSMF1 | 5 | MINISMDC050F-2 |  | 15
ICSP1 | ICSP1 | 2X05 | 1 | 2-1761605-3 |  | 3
J1 | J1 | 09 03 164 6919 | 1 | 0903 164 6921 |  | 3
LDO1 | LDO1 | SOT223 | 1 | NCP1117ST50T3G |  | 3
LED2 | LED1 | CHIP-LED0805 | 1 | KPT-2012SGC |  | 3
LED1 | LED2 | LEDRED | 1 | 550-0407F |  | 3
LT2_LV2, LT2_LV4 | LT1_A, LT1_D | S8E | 2 | LT8302ES8E#PBF |  | 6
Q1_LV1, Q1_LV3 | Q1_B, Q1_C | INF-PG-TDSON-8-1_V | 2 | BSC320N20NS3 G |  | 6
R9_LV1, R9_LV3 | R13_B, R13_C | J1-0603 | 2 |  | 0 | 6
RESET1 | RESET1 | 1-1825027-4 | 1 | 1-1825027-4 |  | 3
 | SSR1, SSR2 | LCA701S | 2 | LCA701S |  | 6
T2_LV2, T2_LV4 | T1_A, T1_D | EP13 | 2 | 750311457 |  | 6
T1_LV1, T1_LV3 | T2_B, T2_C | EFD20 | 2 | 750311597 |  | 6
U3 | U1 | 100A_N | 1 | ATmega2560-16AU |  | 3
U2_LV2, U2_LV4, U5_LV1, U5_LV3 | U2_A, U2_D, U3_B, U3_C | SOT-23 | 4 | INA138NA/250 |  | 12
U4_LV1, U4_LV3 | U4_B, U4_C | LT-MS-16-4PR_N | 2 | LT3748IMS#PBF |  | 6
U1, U2 | U5, U6 | SOICN8 | 2 | ADM4855ARZ |  | 6
Y1 | Y1 | RESONATOR | 1 | CSTCE16M0V53-R0 |  | 3
AC1, AC2, AC3, AC4, AC5, AC6, C2, C3, C8_LV2, C8_LV4, C28_LV1, C28_LV3 | AC1, AC2, AC3, AC4, AC5, AC6, C3_A, C3_D, C12_B, C12_C, C25, C26 | 1608[0603] | 12 | CC0603KRX7R9BB104 | 0.1uF | 36
RLED1 | AR6 | J1-0603 | 1 |  | 1k | 3
AR2 | AR1 | J1-0603 | 1 |  | 1M | 3
R_L1, R_L2, R_L3, R_L4 | R24, R25, R26, R31 | J1-0603 | 4 |  | 1R | 12
C12_LV2, C12_LV4 | C11_A, C11_D | 1608[0603] | 2 | 06033D105KAT2A | 1uF | 6
C27_LV1, C27_LV3 | C13_B, C13_C, C24_B, C24_C | C0805 | 2 | MC0805F105Z500CT | 1uF | 6
L1, L2, L3, L4 | L1, L2, L3, L4 | MPLC0730 | 4 | MPLC0730L1R0 | 1uH | 12
C22_LV1, C22_LV3 | C6_A, C6_D, C7_A, C7_D, C8_A, C8_D, C14_B, C14_C, C15_B, C15_C, C16_B, C16_C, C17_B, C17_C | C1210 | 14 | C1210C225K1RACTU | 2.2uF | 42
R_pu1, R_pu2 | AR4, AR5 | J1-0603 | 2 |  | 4.7K | 6
C30, C31, C32, C33 | C39, C45, C46, C47 | 1812 | 4 | C1812C472KDRACTU | 4.7nF | 12
R3_LV1, R3_LV3 | R15_B, R15_C | J1-0603 | 2 |  | 6.04K | 6
R4_LV1, R4_LV3, R_NTC, R_pu5, Rref2_LV2, Rref2_LV4 | AR3, R16_B, R16_C, R29, Rref1_A, Rref1_D | J1-0603 | 6 |  | 10k | 18
NTC | NTC1 | J1-0603 | 1 | NCP18XH103J03RB | 10K | 3
R16_LV1, R16_LV3 | R17_B, R17_C | C1206 | 2 | LRMAM1206-R01FT5 | 10m | 6
C11_LV2, C11_LV4 | C4_A, C4_D | C1210 | 2 | UMK325BJ106KM-T | 10uF | 6
R7_LV2, R7_LV4, R14_LV1, R14_LV3 | R5_A, R5_D, R12_B, R12_C | J1-0603 | 4 |  | 15k | 12
C1 | C40 | PANASONIC_D | 1 | EMZA500ADA220MF61G | 22uF | 3
RADRS0, RADRS1, RADRS2, RADRS3 | R18, R19, R20, R21 | J1-0603 | 4 |  | 47k | 12
C20, C21 | C1, C2 | PANASONIC_D | 2 | EEE1EA470WAP | 47uF | 6
Rsense1_LV1, Rsense1_LV3, Rsense2_LV2, Rsense2_LV4 | R2_A, R2_D, R7_B, R7_C | R6432 | 4 | MCS3264R050FER | 50m | 12
R1, R2 | R22, R23 | J1-0603 | 2 |  | 50R | 6
R15_LV1, R15_LV3 | R14_B, R14_C | J1-0603 | 2 |  | 75k | 6
R12_LV1, R12_LV3 | R9_B, R9_C | J1-0603 | 2 |  | 82k | 6
R5_LV2, R5_LV4, R10_LV1, R10_LV3 | R1_A, R1_D, R6_B, R6_C | J1-0603 | 4 |  | 100k | 12
R8_LV2, R8_LV4, R13_LV1, R13_LV3 | R4_A, R4_D, R10_B, R10_C, R11_B, R11_C | C1206 | 6 |  | 100R | 18
C3_a_LV1, C3_a_LV3, C3_b_LV1, C3_b_LV3, C4, C8, C9_LV2, C9_LV4, C10_LV2, C10_LV4, C12, C16 | C27, C28, C29, C31, C32, C33, C35, C36, C37, C41, C42, C43 | C1210 | 12 | CL32A107MPVNNNE | 100uF | 36
C5, C6, C7, C9, C10, C11, C13, C14, C15, C17, C18, C19 | C9_A, C9_D, C10_A, C10_D, C19_B, C19_C, C20_B, C20_C, C30, C34, C38, C44 | C1210 | 12 | C3225X5R0J107M250AC | 100uF | 36
Rtc2_LV2, Rtc2_LV4 | Rtc1_A, Rtc1_D | J1-0603 | 2 |  | 169k | 6
Rfb2_LV2, Rfb2_LV4 | Rfb1_A, Rfb1_D | J1-0603 | 2 |  | 200k | 6
 | C23_B, C23_C | 1608[0603] | 2 | C1005C0G1H471J050BA | 470p | 6
C13_LV2, C13_LV4 | C5_A, C5_D | C0805 | 2 | 08055A221JAT2A | 470p | 6
R6_LV2, R6_LV4, R11_LV1, R11_LV3 | R3_A, R3_D, R8_B, R8_C | J1-0603 | 4 |  | 500k | 12
R_LED1, R_LED2, R_LED3, R_LED4, R_LED5, R_LED6, RLED2 | AR2, R27, R28, R30, R32, R33, R34 | J1-0603 | 7 |  | 500R | 21
C23_LV1, C23_LV3 | C18_B, C18_C | C0805 | 2 | 08055A221JAT2A | 680pF | 6
 | C21_B, C21_C | 1608[0603] | 2 |  | 2000pF | 6
 | C22_B, C22_C | 1608[0603] | 2 | 04025C472KAT2A | 4700pF | 6
