smkilani/G-2/LVBackplane/3D/LV1.step

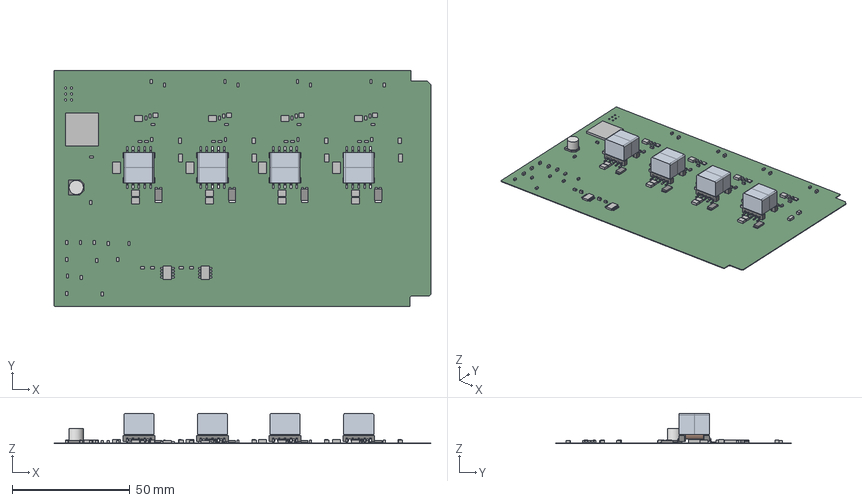
[picture p6: CAD file, 2015-06-29]
LVBackplane/3D/LV1.step
159.9 x 100.0 x 12.8 mm
Board
Extruded x 114
Gehäuse x 4
Core_EP-13 x 8
