smkilani/G-2/LVBackplane/connector.stp

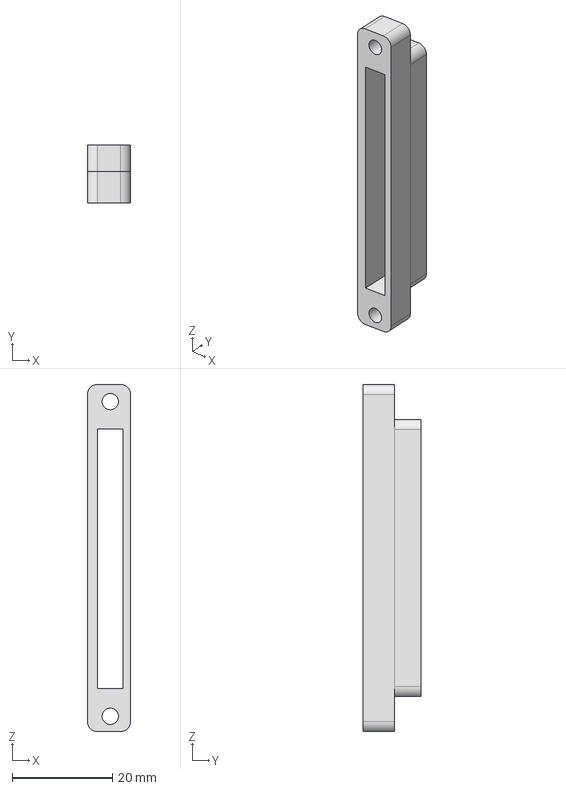
[picture p7: CAD file, 2015-06-18]
LVBackplane/connector.stp
8.63 x 11.6 x 69.2 mm
