smkilani/G-2/LVBackplane/3D/10046971004lf.stp

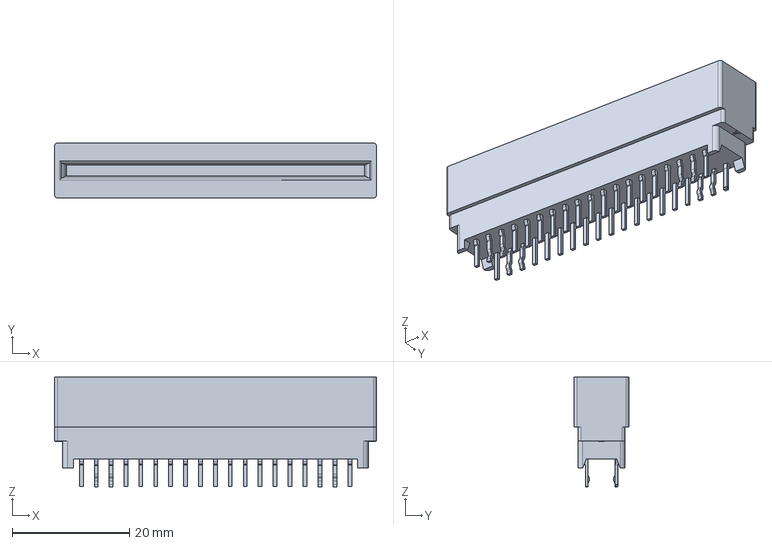
[picture p8: CAD file, 2015-06-23]
LVBackplane/3D/10046971004lf.stp
54.8 x 9.35 x 18.7 mm
