smkilani/G-2/(list of files, cad)

Other CAD files:
LVBackplane/3D/24563131.iam
LVBackplane/3D/24563131_01.ipt
LVBackplane/3D/24563131_02.ipt
LVBackplane/3D/24563131_03.ipt
LVBackplane/3D/24563131_04.ipt
LVBackplane/3D/24563131_05.ipt
LVBackplane/3D/24563131_06.ipt
LVBackplane/3D/24563131_07.ipt
LVBackplane/3D/24563131_08.ipt
LVBackplane/3D/24563131_09.ipt
LVBackplane/3D/24563131_10.ipt
LVBackplane/3D/24563131_11.ipt
LVBackplane/3D/24563131_12.ipt
LVBackplane/3D/24563131_13.ipt
LVBackplane/3D/24563131_14.ipt
LVBackplane/3D/24563131_15.ipt
LVBackplane/3D/24563131_16.ipt
LVBackplane/3D/24563131_17.ipt
LVBackplane/3D/24563131_18.ipt
LVBackplane/3D/24563131_19.ipt
LVBackplane/3D/24563131_20.ipt
LVBackplane/3D/24563131_21.ipt
LVBackplane/3D/24563131_22.ipt
LVBackplane/3D/24563131_23.ipt
LVBackplane/3D/24563131_24.ipt
LVBackplane/3D/24563131_25.ipt
LVBackplane/3D/24563131_26.ipt
LVBackplane/3D/Imported Components/Backplane/10046971004lf.ipt
LVBackplane/3D/Imported Components/Backplane/172-009-212.ipt
LVBackplane/3D/Imported Components/Backplane/424108312.iam
LVBackplane/3D/Imported Components/Backplane/574386432.iam
LVBackplane/3D/Imported Components/Backplane/574387872.iam
LVBackplane/3D/Imported Components/Backplane/574400032.iam
LVBackplane/3D/Imported Components/Backplane/574400192.iam
LVBackplane/3D/Imported Components/Backplane/584737440.iam
LVBackplane/3D/Imported Components/Backplane/584738240.iam
LVBackplane/3D/Imported Components/Backplane/584749120.iam
LVBackplane/3D/Imported Components/Backplane/712055936.iam
LVBackplane/3D/Imported Components/Backplane/Backplane.iam
LVBackplane/3D/Imported Components/Backplane/Board.ipt
LVBackplane/3D/Imported Components/Backplane/C1.iam
LVBackplane/3D/Imported Components/Backplane/C10.iam
LVBackplane/3D/Imported Components/Backplane/C11.iam
LVBackplane/3D/Imported Components/Backplane/C12.iam
LVBackplane/3D/Imported Components/Backplane/C13.iam
LVBackplane/3D/Imported Components/Backplane/C14.iam
LVBackplane/3D/Imported Components/Backplane/C15.iam
LVBackplane/3D/Imported Components/Backplane/C16.iam
LVBackplane/3D/Imported Components/Backplane/C1_U1.iam
LVBackplane/3D/Imported Components/Backplane/C1_U2.iam
LVBackplane/3D/Imported Components/Backplane/C1_U3.iam
LVBackplane/3D/Imported Components/Backplane/C1_U4.iam
LVBackplane/3D/Imported Components/Backplane/C1_U5.iam
LVBackplane/3D/Imported Components/Backplane/C1_U6.iam
LVBackplane/3D/Imported Components/Backplane/C1_U7.iam
LVBackplane/3D/Imported Components/Backplane/C1_U8.iam
LVBackplane/3D/Imported Components/Backplane/C2.iam
LVBackplane/3D/Imported Components/Backplane/C2_U1.iam
LVBackplane/3D/Imported Components/Backplane/C2_U2.iam
LVBackplane/3D/Imported Components/Backplane/C2_U3.iam
LVBackplane/3D/Imported Components/Backplane/C2_U4.iam
LVBackplane/3D/Imported Components/Backplane/C2_U5.iam
LVBackplane/3D/Imported Components/Backplane/C2_U6.iam
LVBackplane/3D/Imported Components/Backplane/C2_U7.iam
LVBackplane/3D/Imported Components/Backplane/C2_U8.iam
LVBackplane/3D/Imported Components/Backplane/C3.iam
LVBackplane/3D/Imported Components/Backplane/C4.iam
LVBackplane/3D/Imported Components/Backplane/C5.iam
LVBackplane/3D/Imported Components/Backplane/C6.iam
LVBackplane/3D/Imported Components/Backplane/C7.iam
LVBackplane/3D/Imported Components/Backplane/C8.iam
LVBackplane/3D/Imported Components/Backplane/C9.iam
LVBackplane/3D/Imported Components/Backplane/DB1.iam
LVBackplane/3D/Imported Components/Backplane/DB10.iam
LVBackplane/3D/Imported Components/Backplane/DB11.iam
LVBackplane/3D/Imported Components/Backplane/DB12.iam
LVBackplane/3D/Imported Components/Backplane/DB13.iam
LVBackplane/3D/Imported Components/Backplane/DB14.iam
LVBackplane/3D/Imported Components/Backplane/DB15.iam
LVBackplane/3D/Imported Components/Backplane/DB16.iam
LVBackplane/3D/Imported Components/Backplane/DB1_U1.iam
LVBackplane/3D/Imported Components/Backplane/DB1_U2.iam
LVBackplane/3D/Imported Components/Backplane/DB1_U3.iam
LVBackplane/3D/Imported Components/Backplane/DB1_U4.iam
LVBackplane/3D/Imported Components/Backplane/DB1_U5.iam
LVBackplane/3D/Imported Components/Backplane/DB1_U6.iam
LVBackplane/3D/Imported Components/Backplane/DB1_U7.iam
LVBackplane/3D/Imported Components/Backplane/DB1_U8.iam
LVBackplane/3D/Imported Components/Backplane/DB2.iam
LVBackplane/3D/Imported Components/Backplane/DB2_U1.iam
LVBackplane/3D/Imported Components/Backplane/DB2_U2.iam
LVBackplane/3D/Imported Components/Backplane/DB2_U3.iam
LVBackplane/3D/Imported Components/Backplane/DB2_U4.iam
LVBackplane/3D/Imported Components/Backplane/DB2_U5.iam
LVBackplane/3D/Imported Components/Backplane/DB2_U6.iam
LVBackplane/3D/Imported Components/Backplane/DB2_U7.iam
LVBackplane/3D/Imported Components/Backplane/DB2_U8.iam
LVBackplane/3D/Imported Components/Backplane/DB3.iam
LVBackplane/3D/Imported Components/Backplane/DB4.iam
LVBackplane/3D/Imported Components/Backplane/DB5.iam
LVBackplane/3D/Imported Components/Backplane/DB6.iam
LVBackplane/3D/Imported Components/Backplane/DB7.iam
LVBackplane/3D/Imported Components/Backplane/DB8.iam
LVBackplane/3D/Imported Components/Backplane/DB9.iam
LVBackplane/3D/Imported Components/Backplane/Extruded.ipt
LVBackplane/3D/Imported Components/Backplane/Extruded_1.ipt
LVBackplane/3D/Imported Components/Backplane/Extruded_2.ipt
LVBackplane/3D/Imported Components/Backplane/Extruded_3.ipt
LVBackplane/3D/Imported Components/Backplane/J1.iam
LVBackplane/3D/Imported Components/Backplane/J10.iam
LVBackplane/3D/Imported Components/Backplane/J11.iam
LVBackplane/3D/Imported Components/Backplane/J12.iam
LVBackplane/3D/Imported Components/Backplane/J13.iam
LVBackplane/3D/Imported Components/Backplane/J14.iam
LVBackplane/3D/Imported Components/Backplane/J15.iam
LVBackplane/3D/Imported Components/Backplane/J16.iam
LVBackplane/3D/Imported Components/Backplane/J1_U1.iam
LVBackplane/3D/Imported Components/Backplane/J1_U2.iam
LVBackplane/3D/Imported Components/Backplane/J1_U3.iam
LVBackplane/3D/Imported Components/Backplane/J1_U4.iam
LVBackplane/3D/Imported Components/Backplane/J1_U5.iam
LVBackplane/3D/Imported Components/Backplane/J1_U6.iam
LVBackplane/3D/Imported Components/Backplane/J1_U7.iam
LVBackplane/3D/Imported Components/Backplane/J1_U8.iam
LVBackplane/3D/Imported Components/Backplane/J2.iam
LVBackplane/3D/Imported Components/Backplane/J3.iam
LVBackplane/3D/Imported Components/Backplane/J4.iam
LVBackplane/3D/Imported Components/Backplane/J5.iam
LVBackplane/3D/Imported Components/Backplane/J6.iam
LVBackplane/3D/Imported Components/Backplane/J7.iam
LVBackplane/3D/Imported Components/Backplane/J8.iam
LVBackplane/3D/Imported Components/Backplane/J9.iam
LVBackplane/3D/Imported Components/Backplane/J_Controller.iam
LVBackplane/3D/Imported Components/Backplane/J_Controller1.iam
LVBackplane/3D/Imported Components/Backplane/OldVersions/10046971004lf.0001.ipt
LVBackplane/3D/Imported Components/Backplane/OldVersions/172-009-212.0001.ipt
LVBackplane/3D/Imported Components/Backplane/OldVersions/172-009-212.0002.ipt
LVBackplane/3D/Imported Components/Backplane/OldVersions/424108312.0001.iam
LVBackplane/3D/Imported Components/Backplane/OldVersions/424108312.0002.iam
LVBackplane/3D/Imported Components/Backplane/OldVersions/574386432.0001.iam
LVBackplane/3D/Imported Components/Backplane/OldVersions/574387872.0001.iam
LVBackplane/3D/Imported Components/Backplane/OldVersions/574400032.0001.iam
LVBackplane/3D/Imported Components/Backplane/OldVersions/574400192.0001.iam
LVBackplane/3D/Imported Components/Backplane/OldVersions/Backplane.0001.iam
LVBackplane/3D/Imported Components/Backplane/OldVersions/Backplane.0002.iam
LVBackplane/3D/Imported Components/Backplane/OldVersions/Board.0001.ipt
LVBackplane/3D/Imported Components/Backplane/OldVersions/Board.0002.ipt
LVBackplane/3D/Imported Components/Backplane/OldVersions/C1_U1.0001.iam
LVBackplane/3D/Imported Components/Backplane/OldVersions/C1_U2.0001.iam
LVBackplane/3D/Imported Components/Backplane/OldVersions/C1_U3.0001.iam
LVBackplane/3D/Imported Components/Backplane/OldVersions/C1_U4.0001.iam
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
