smkilani/G-2/PCB - Rack 2/G2_LV.pdf

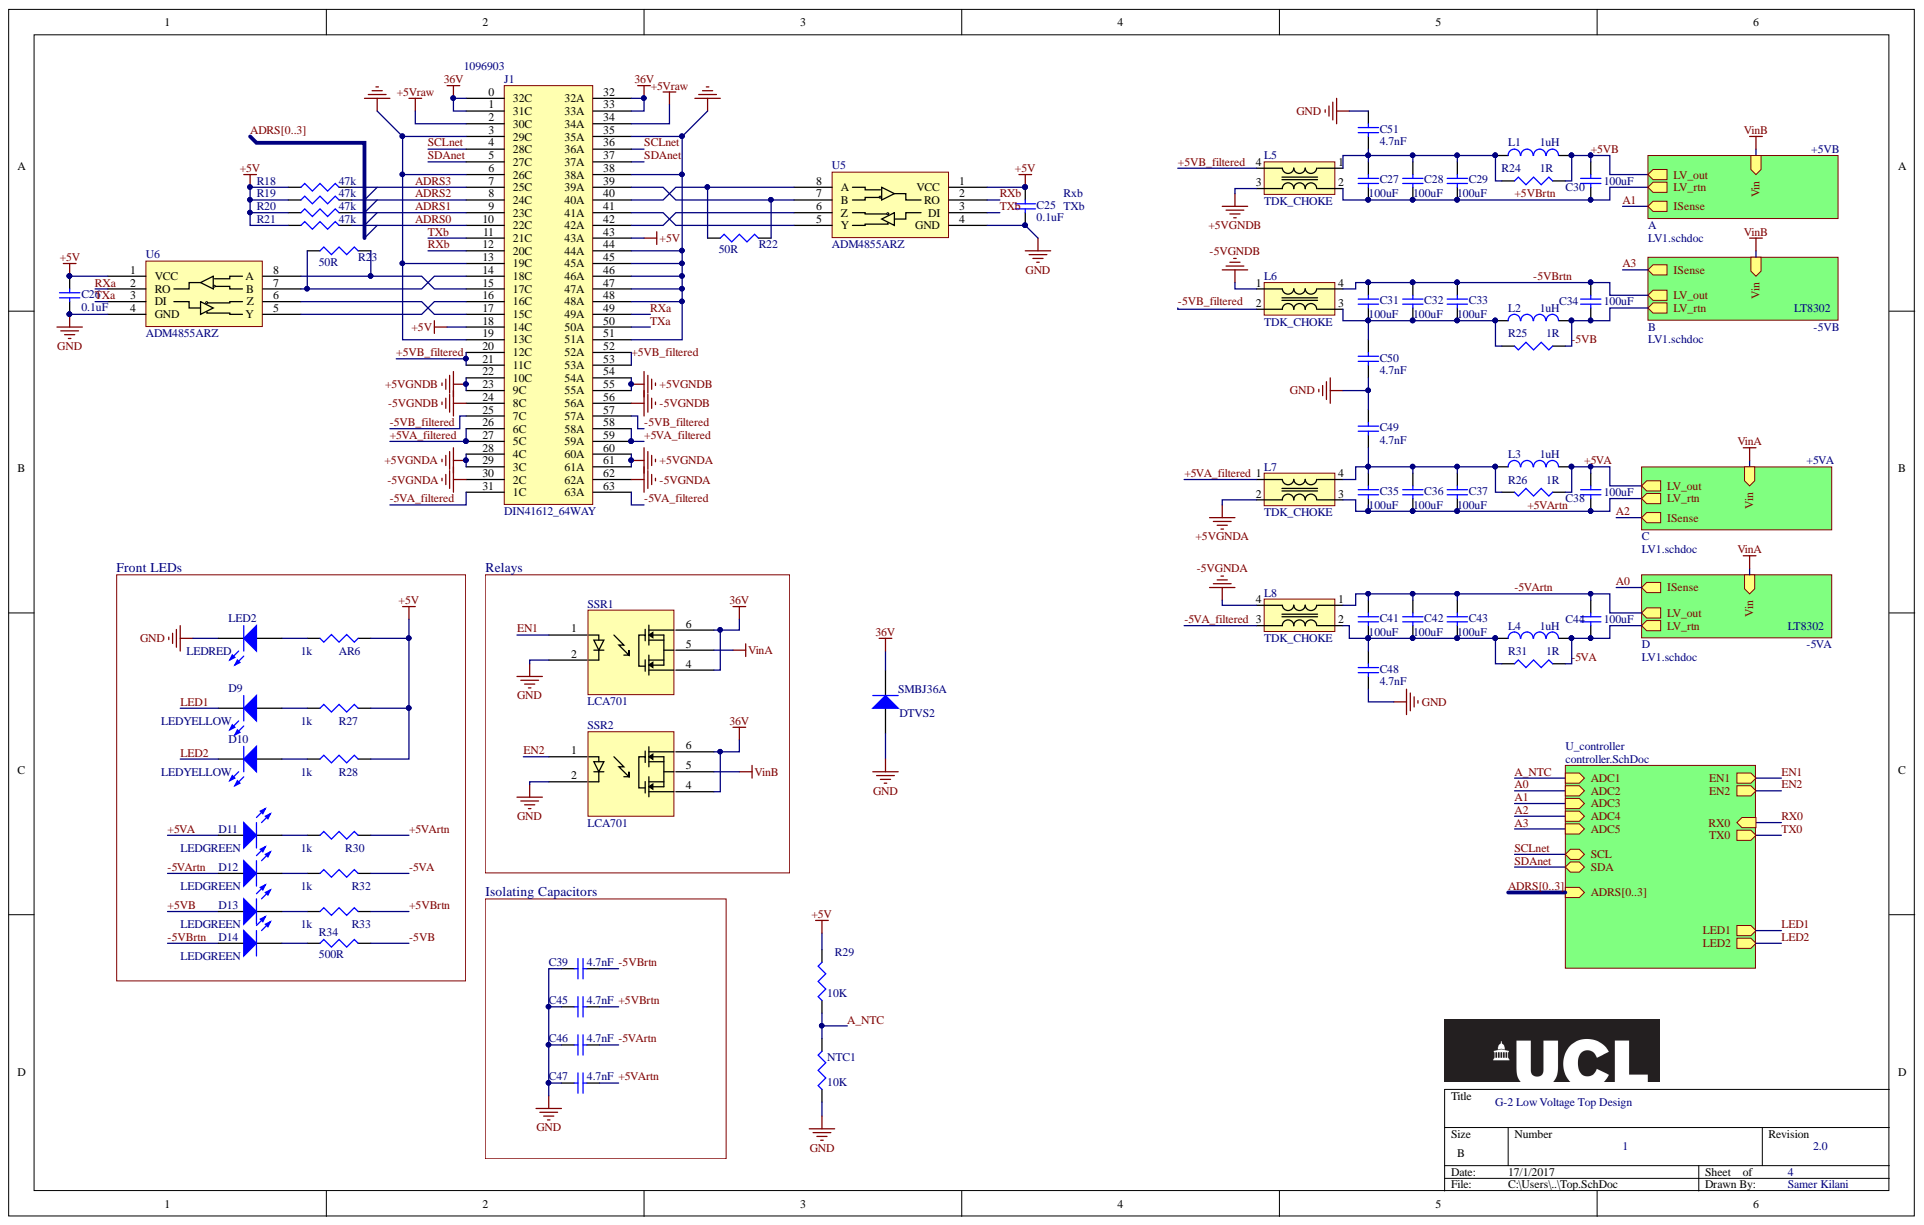
[picture p9: page 1]

VinB VinB VinA VinA

+5VA_fi l tered | 5C 27

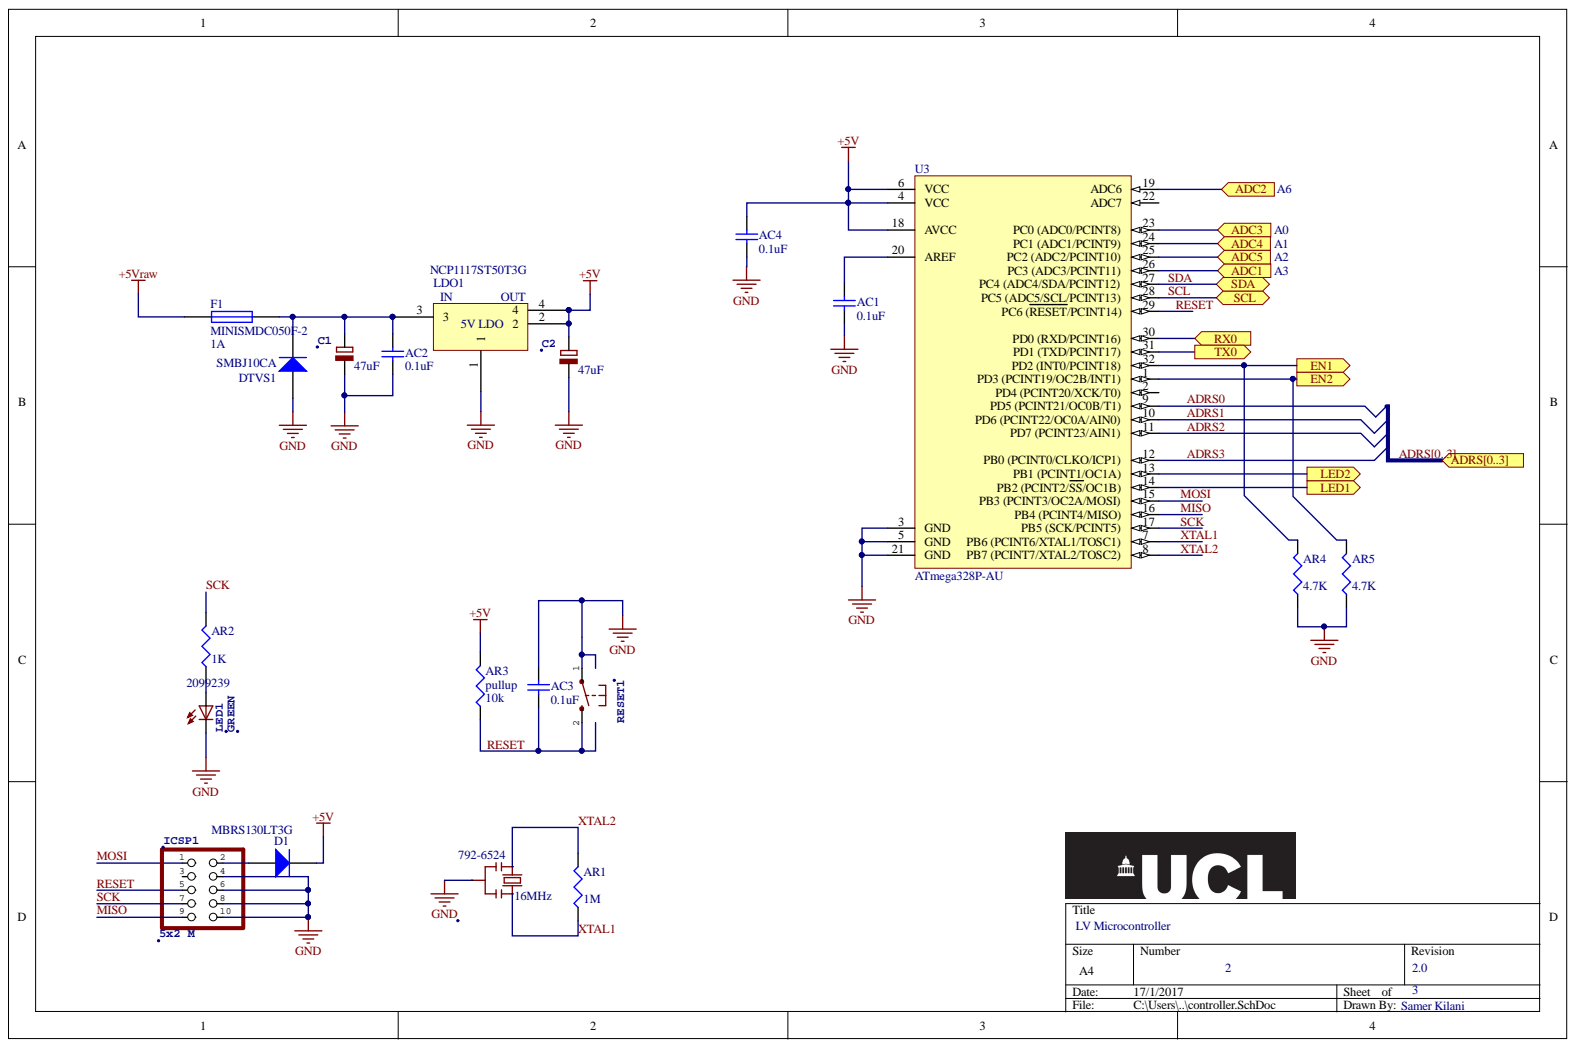
[picture p10: page 2]

Numbe r 2 | R evision 2. 0

: 17/1/2017 | She et of 3
File : C:\Use rs\. .\controlle r . S chDoc | D r a wn By: S ame r Kilani

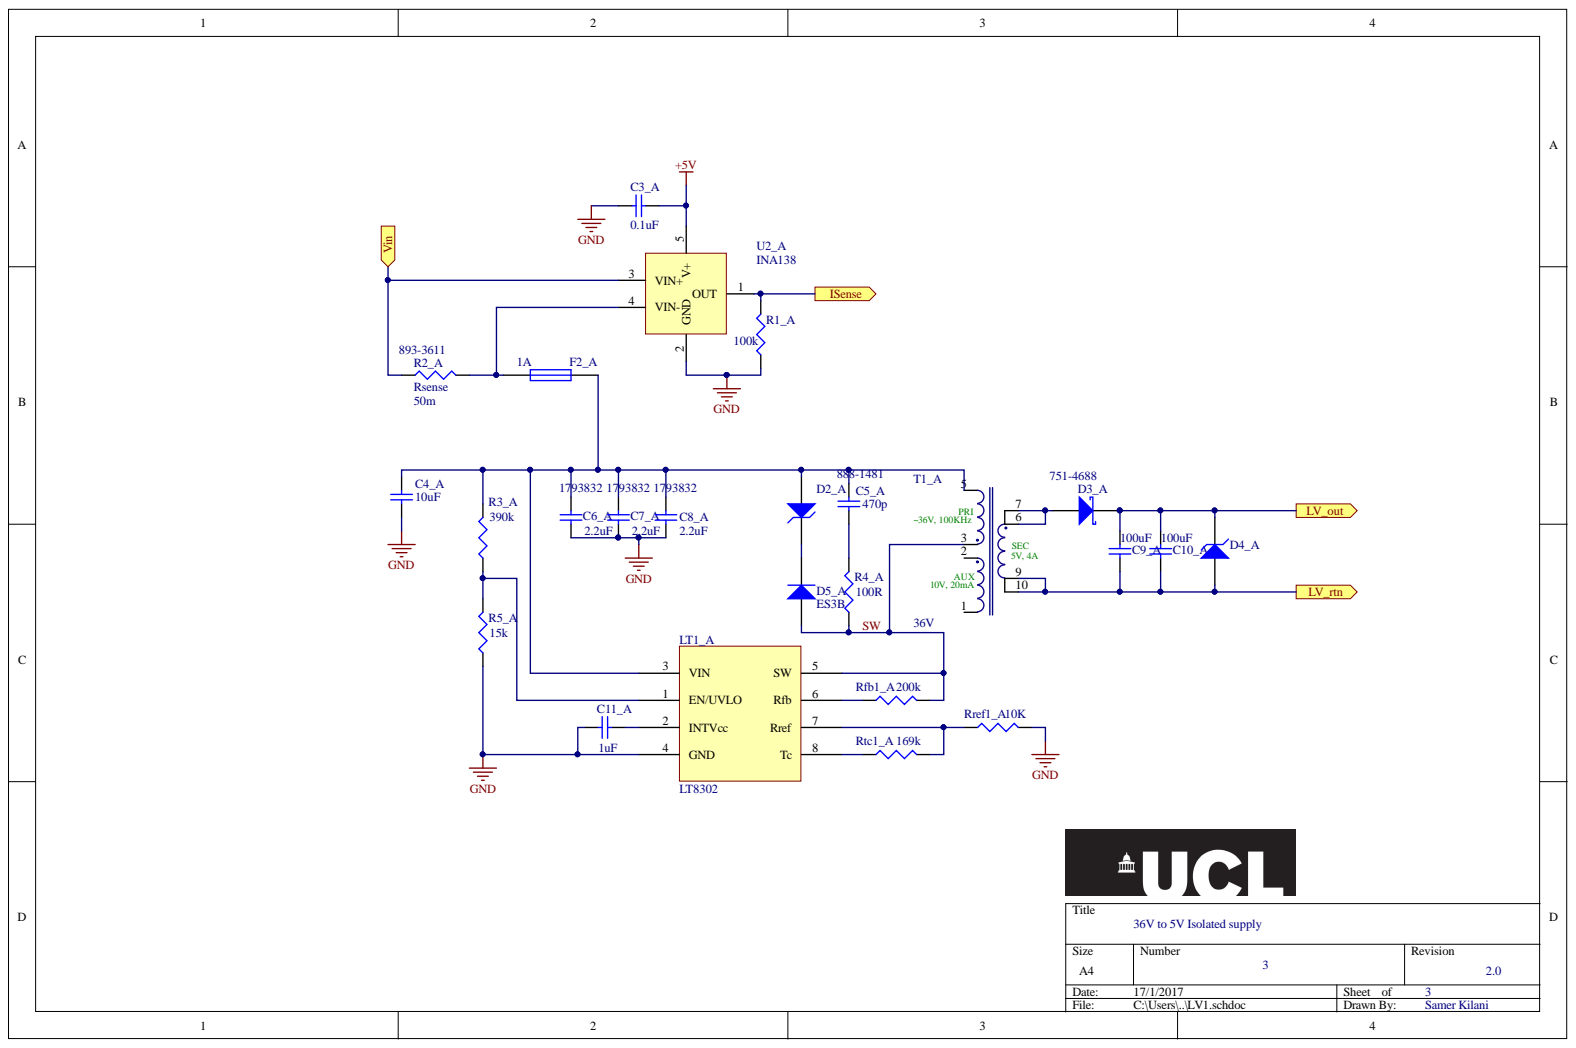
[picture p11: page 3]

Size A4 | Number 3 | Revision 2.0

Date: 17/1/2017 | Sheet of 3
File: C:\Users\..\LV1.schdoc | Drawn By: Samer Kilani

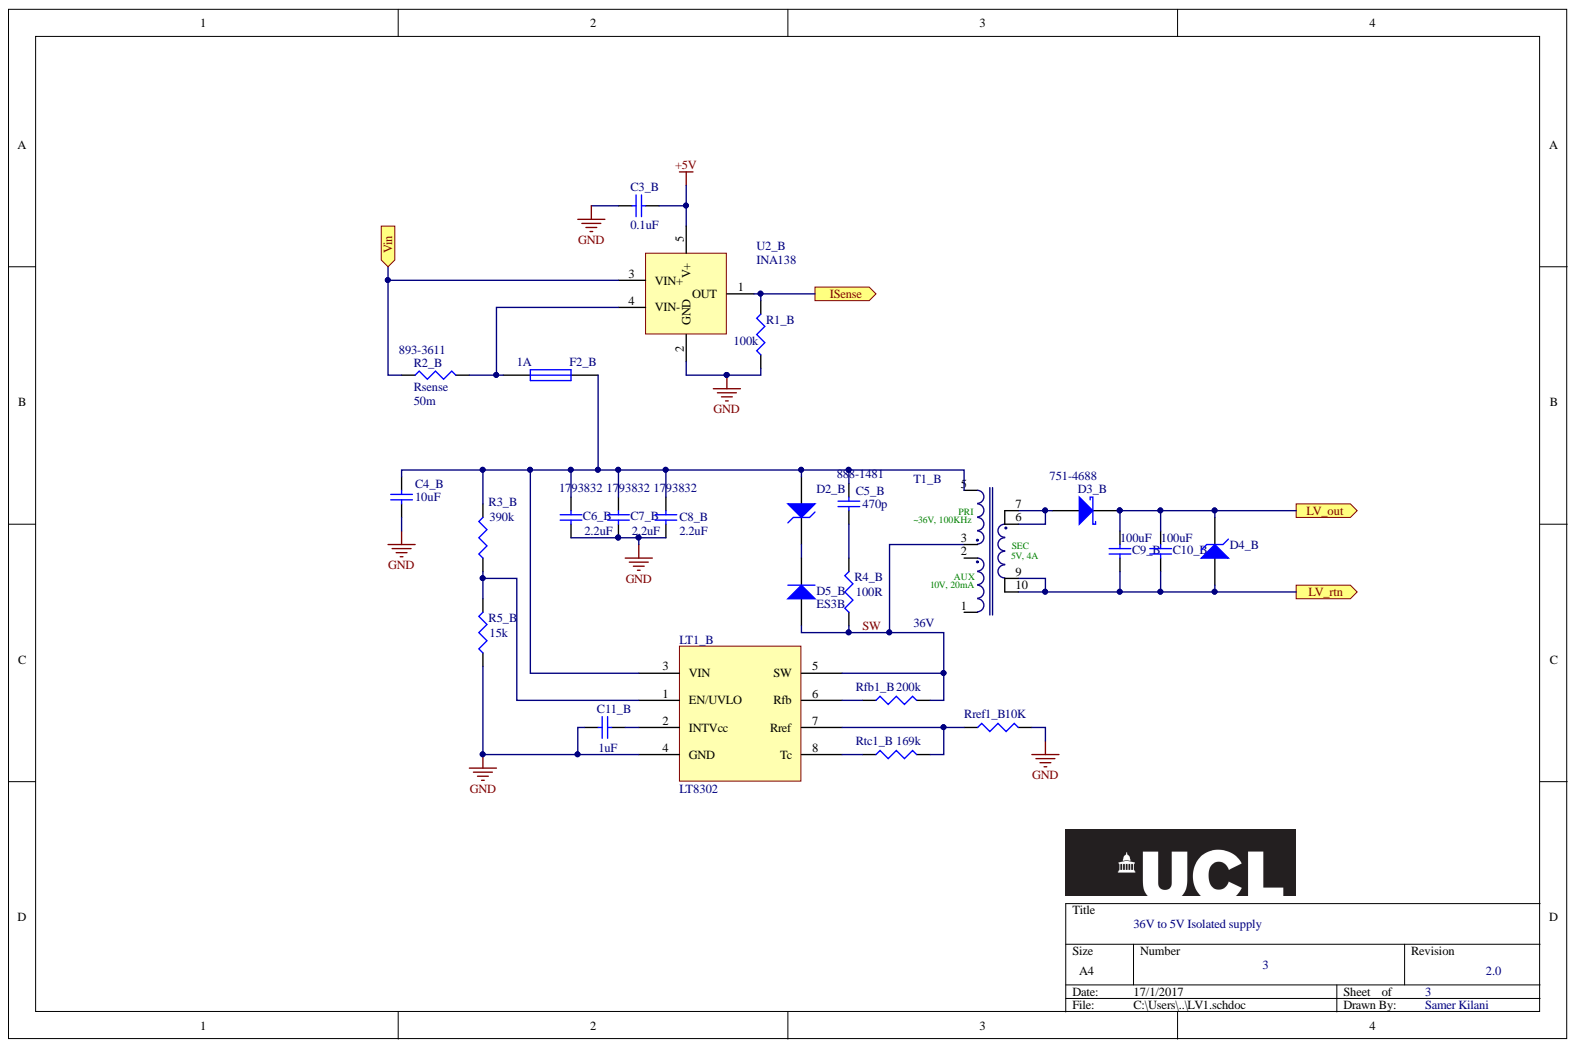
[picture p12: page 4]

Size A4 | Number 3 | Revision 2.0

Date: 17/1/2017 | Sheet of 3
File: C:\Users\..\LV1.schdoc | Drawn By: Samer Kilani

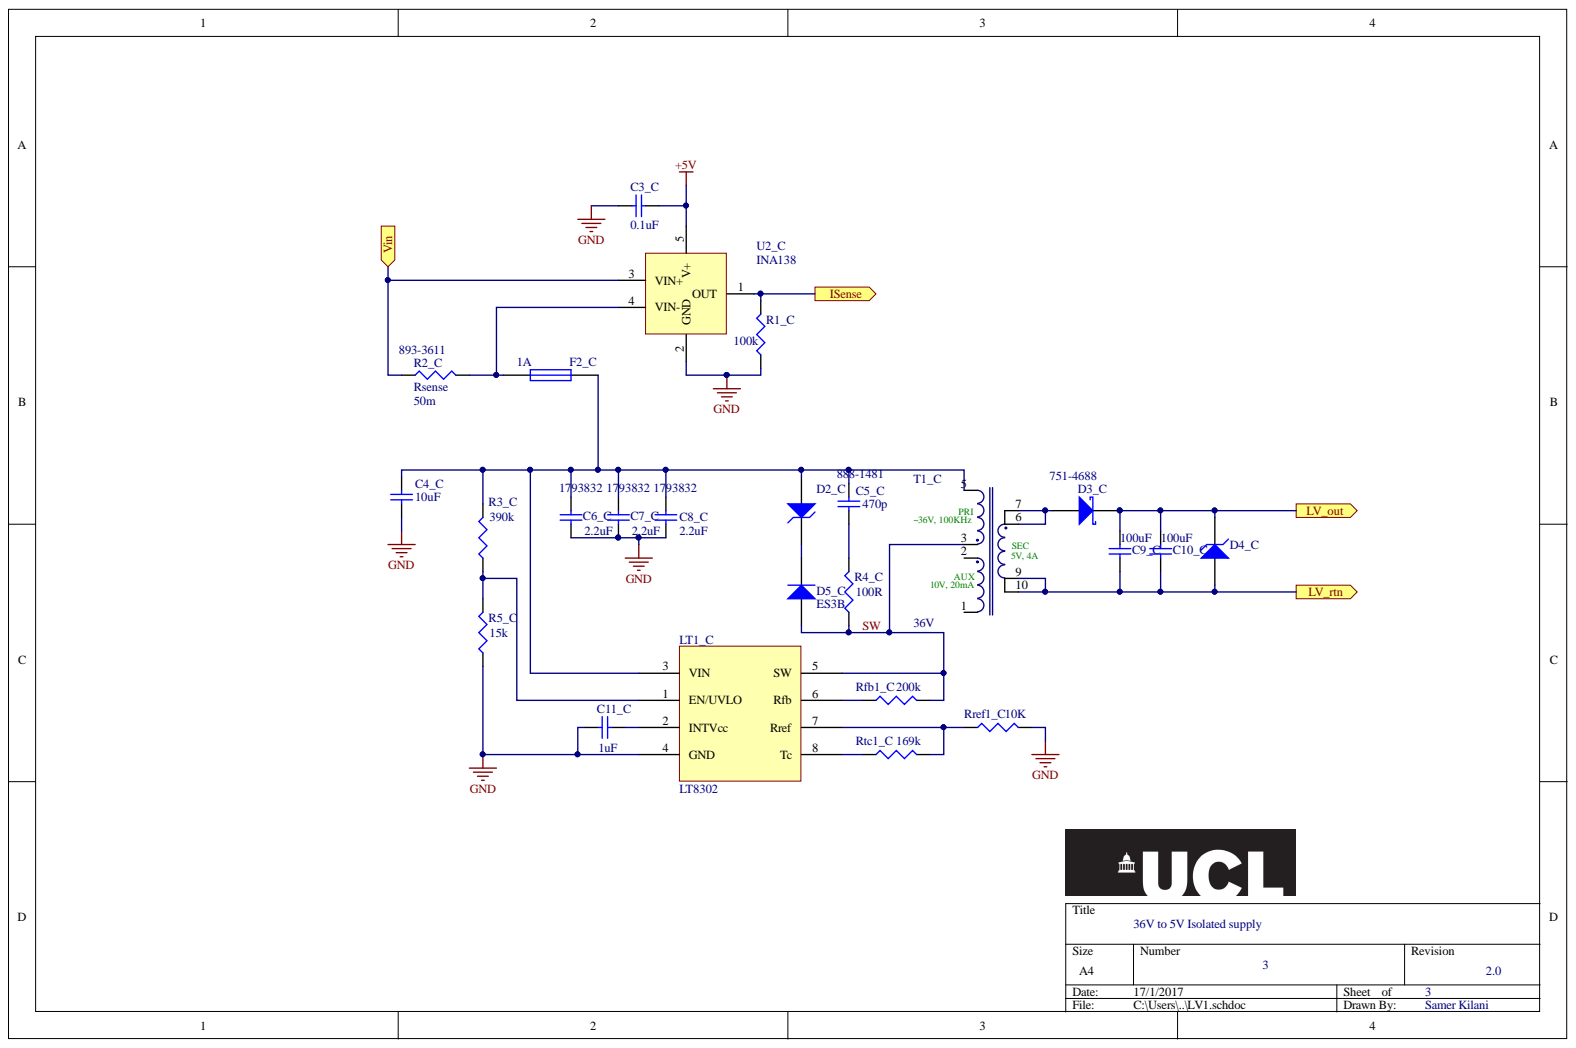
[picture p13: page 5]

Size A4 | Number 3 | Revision 2.0

Date: 17/1/2017 | Sheet of 3
File: C:\Users\..\LV1.schdoc | Drawn By: Samer Kilani

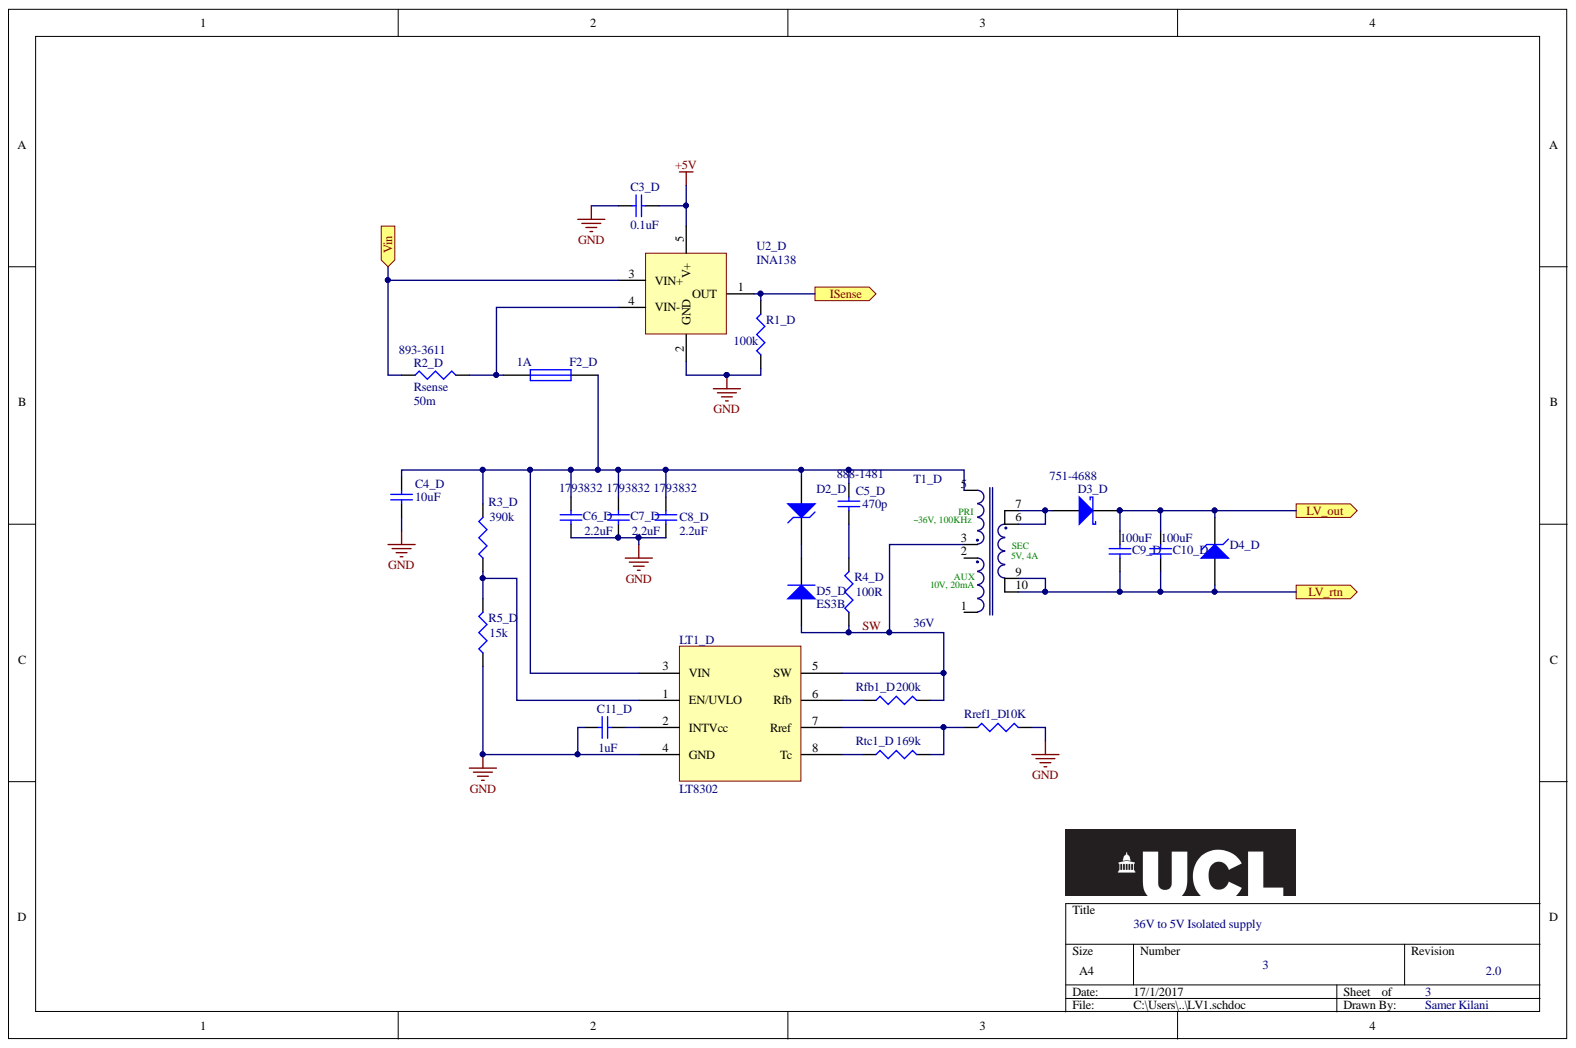
[picture p14: page 6]

Size A4 | Number 3 | Revision 2.0

Date: 17/1/2017 | Sheet of 3
File: C:\Users\..\LV1.schdoc | Drawn By: Samer Kilani

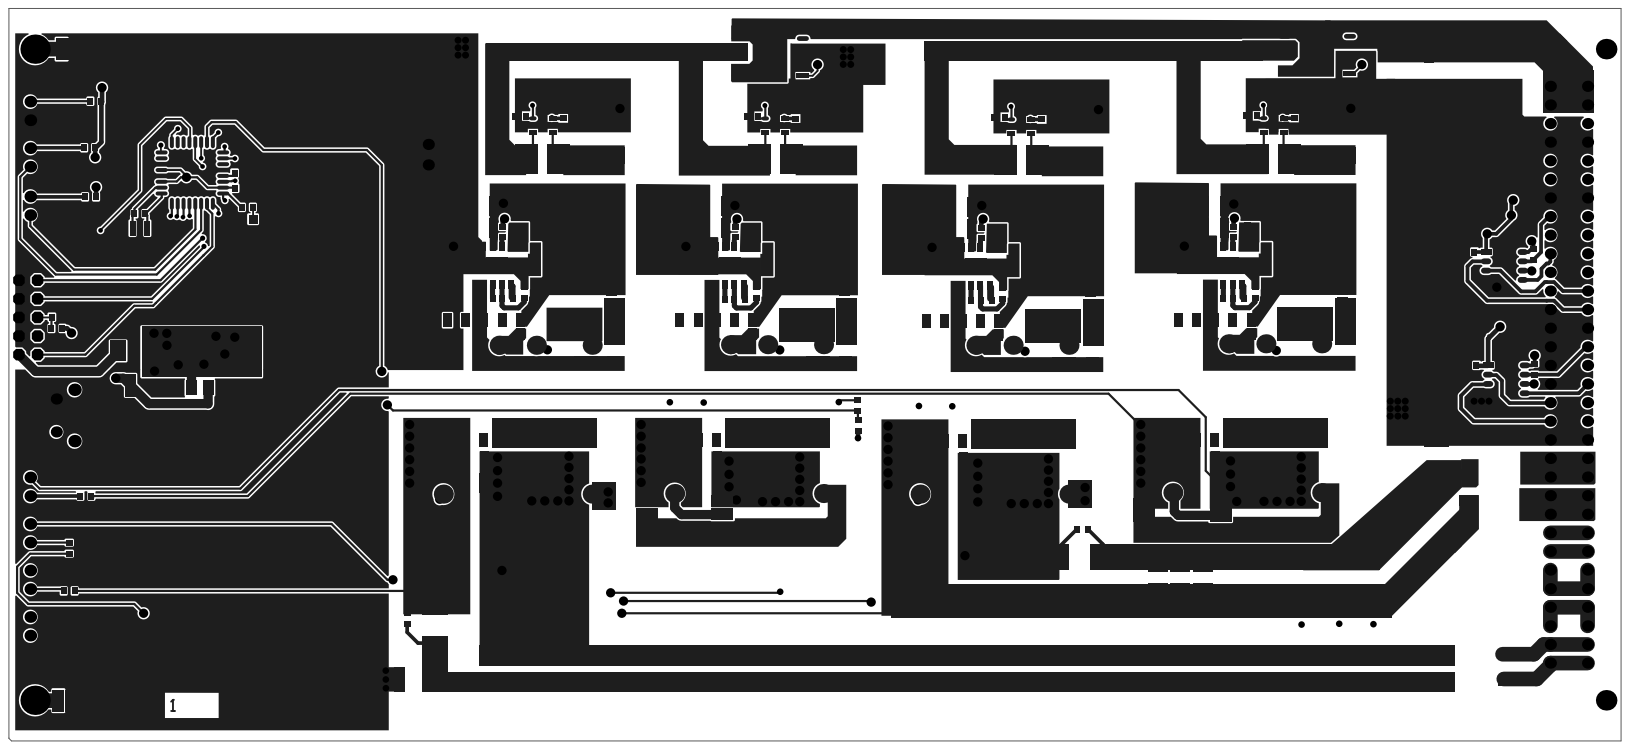
[picture p15: page 7]
