smkilani/G-2/PCB - Rack/G2_LV.PDF

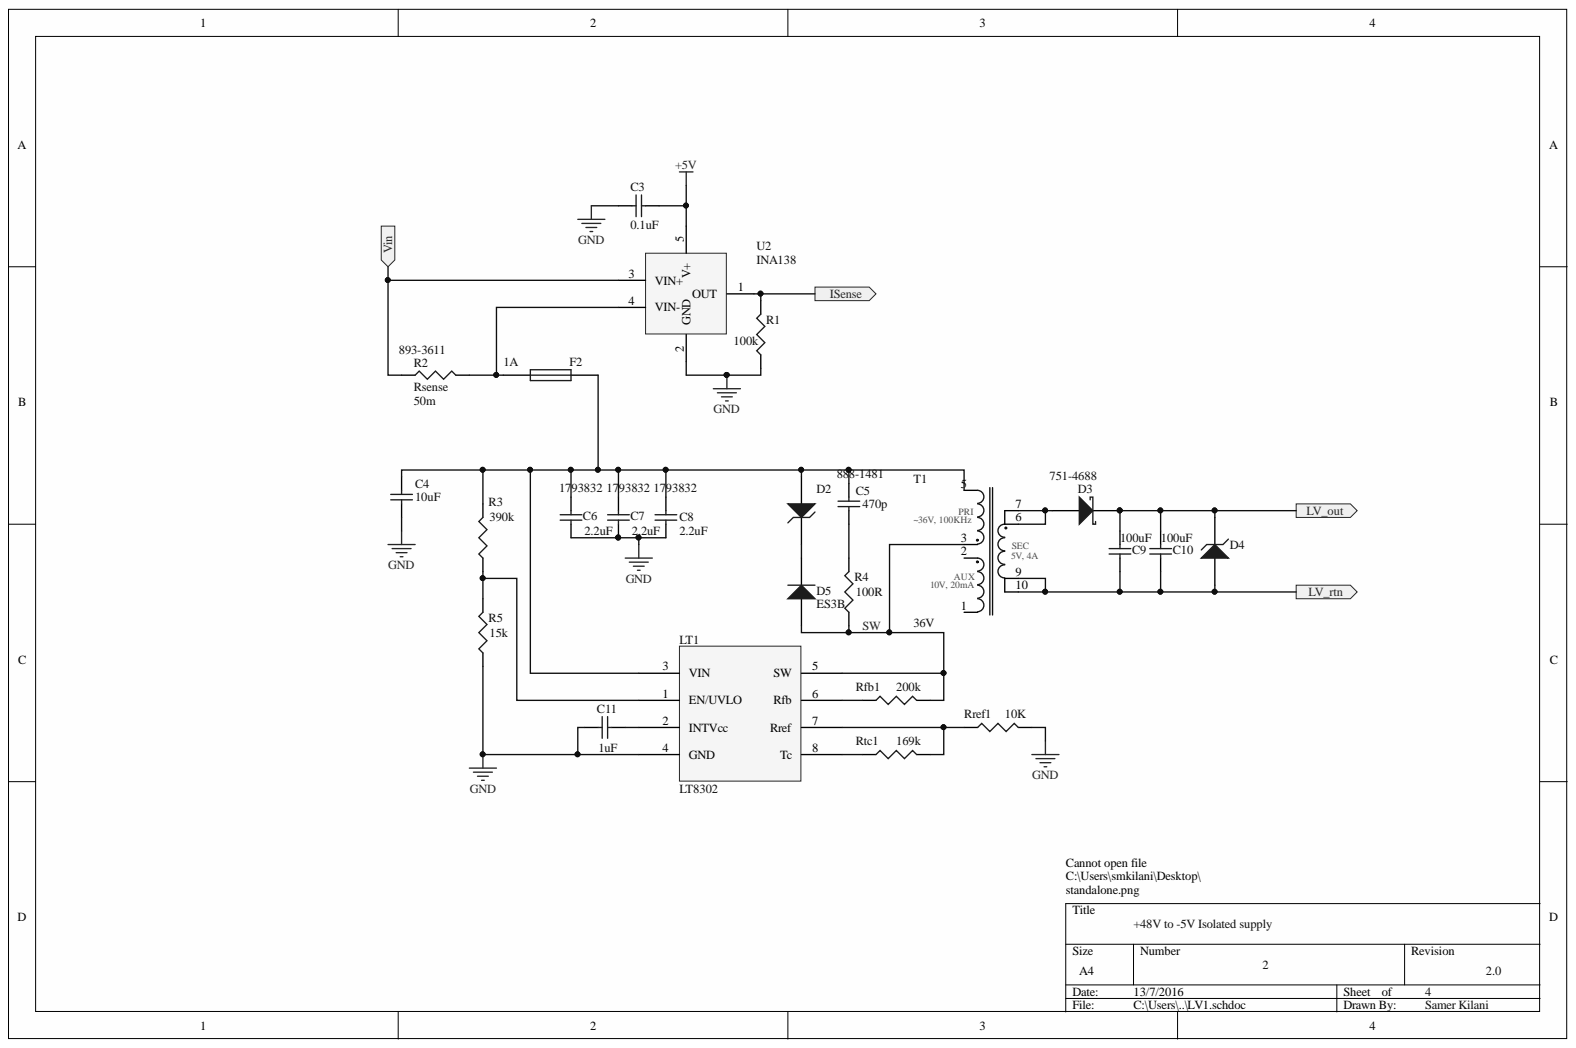
[picture p16: page 1]

Size A4 | Number 2 | Revision 2.0

Date: 13/7/2016 | Sheet of 4
File: C:\Users\..\LV1.schdoc | Drawn By: Samer Kilani

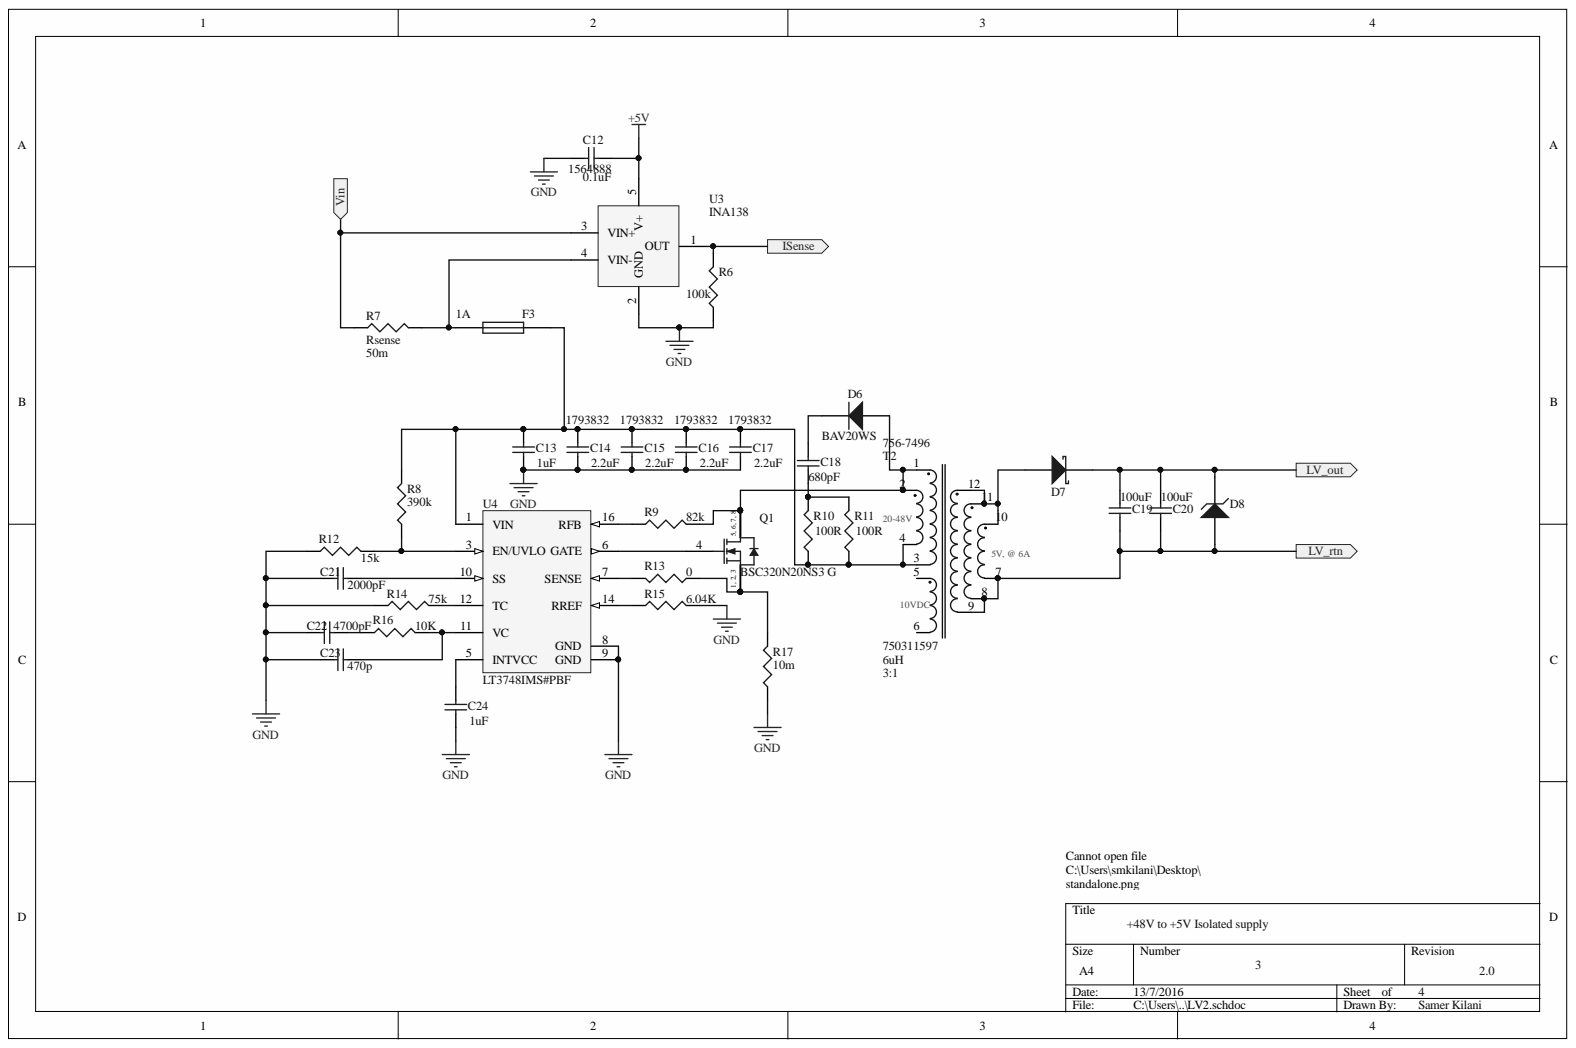
[picture p17: page 2]

Size A4 | Number 3 | Revision 2.0

Date: 13/7/2016 | Sheet of 4
File: C:\Users\..\LV2.schdoc | Drawn By: Samer Kilani

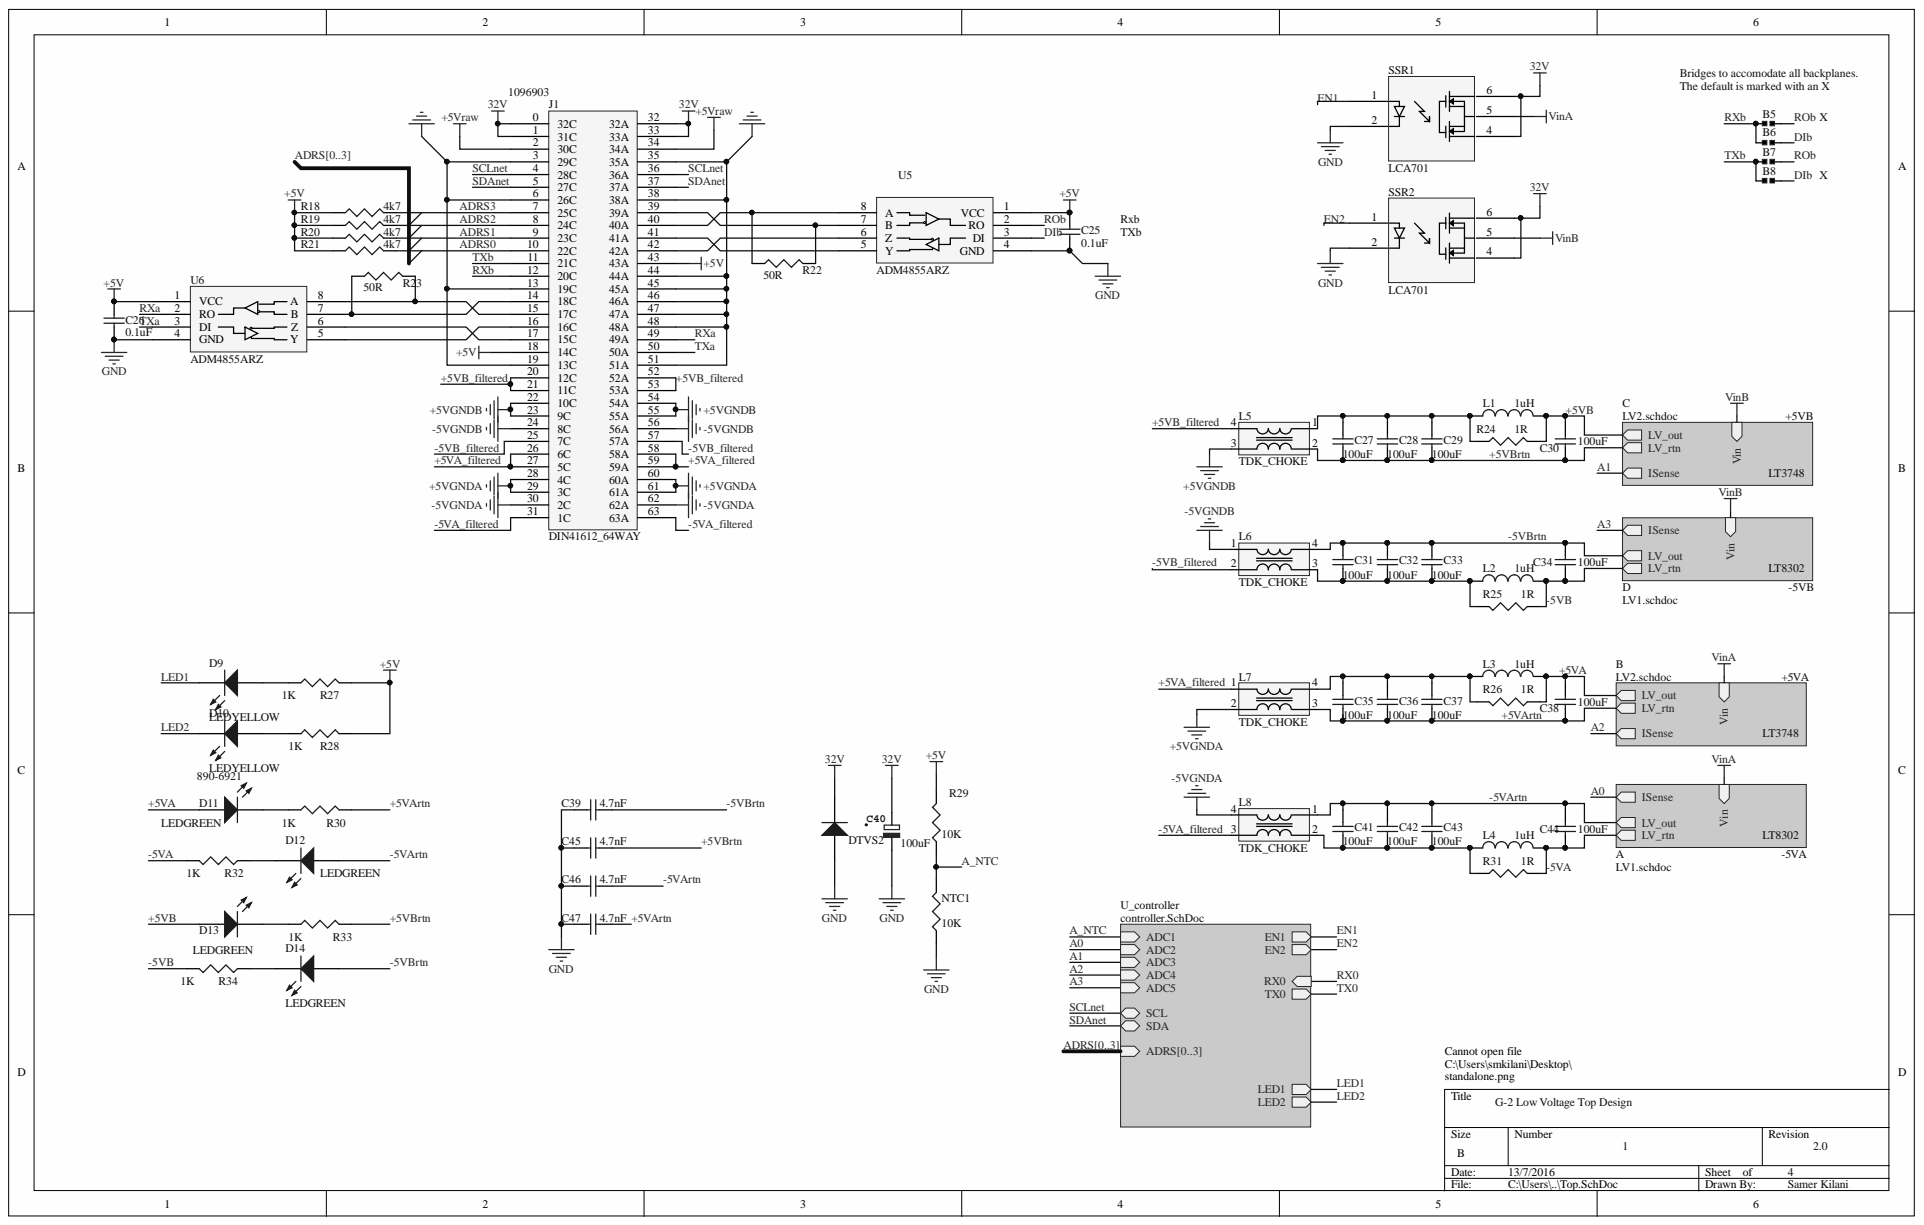
[picture p18: page 3]

Bridges to accomodate all backplanes.
The default is marked with an X

G-2 Low Voltage Top Design

Size B | Number 1 | Revision 2.0

Date: 13/7/2016 | Sheet of 4
File: C:\Users\..\Top.SchDoc | Drawn By: Samer Kilani
