smkilani/G-2/LVBackplane/Backplane.PDF

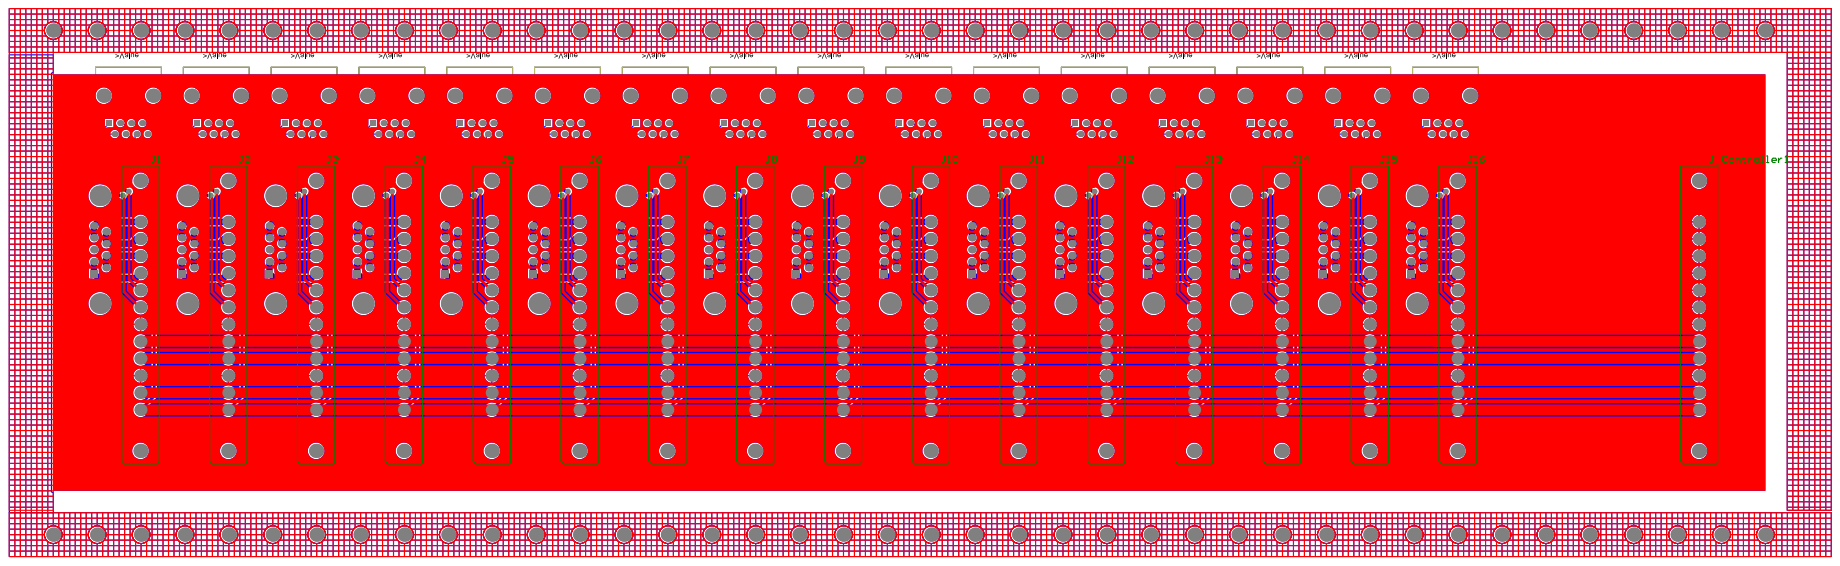
[picture p19: page 1]
