smkilani/G-2/PCB - Standalone/G2_LV.PDF

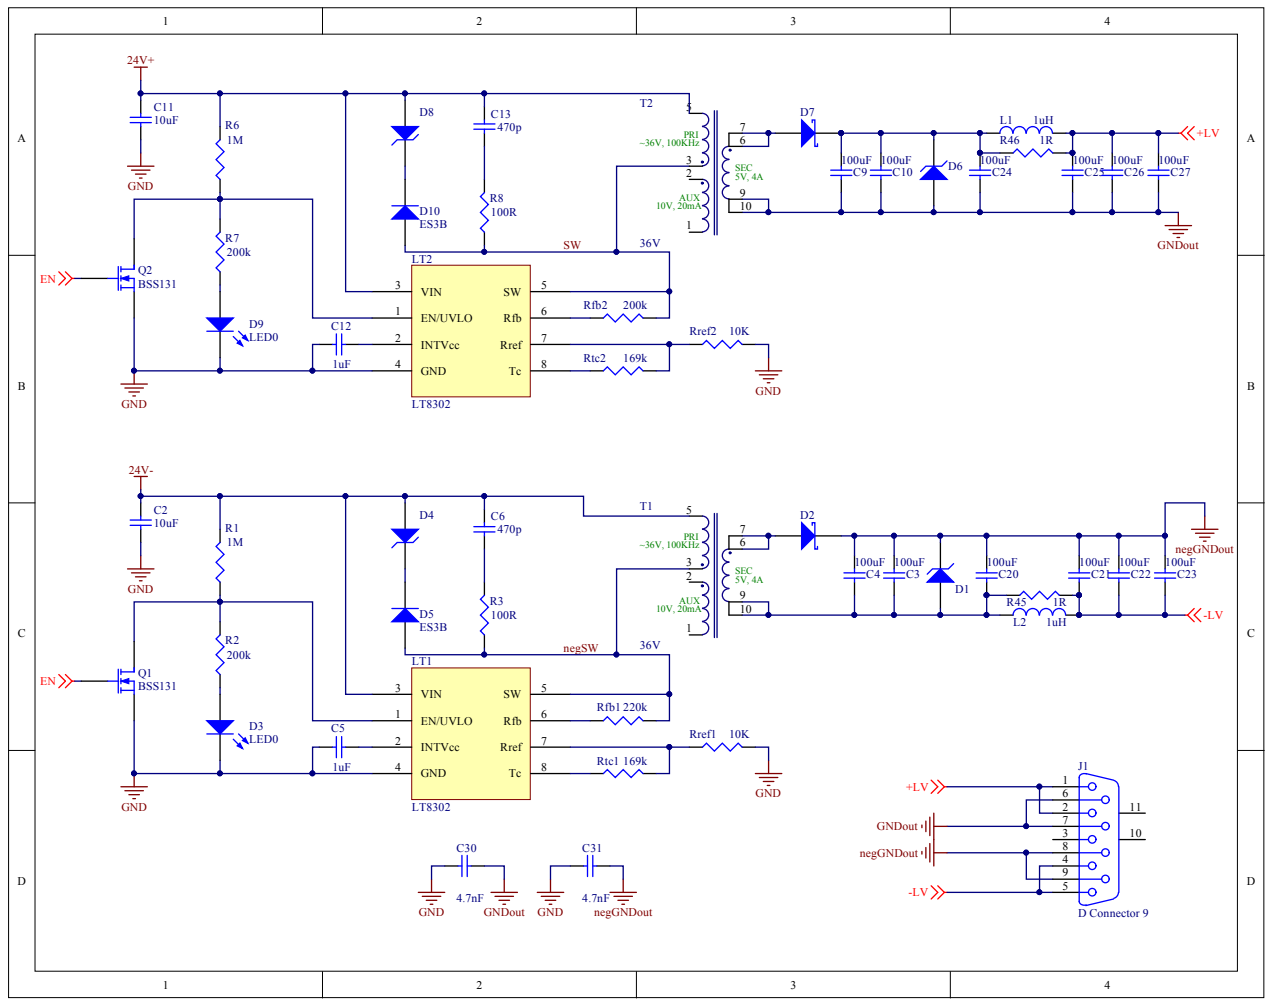
[picture p20: page 1]

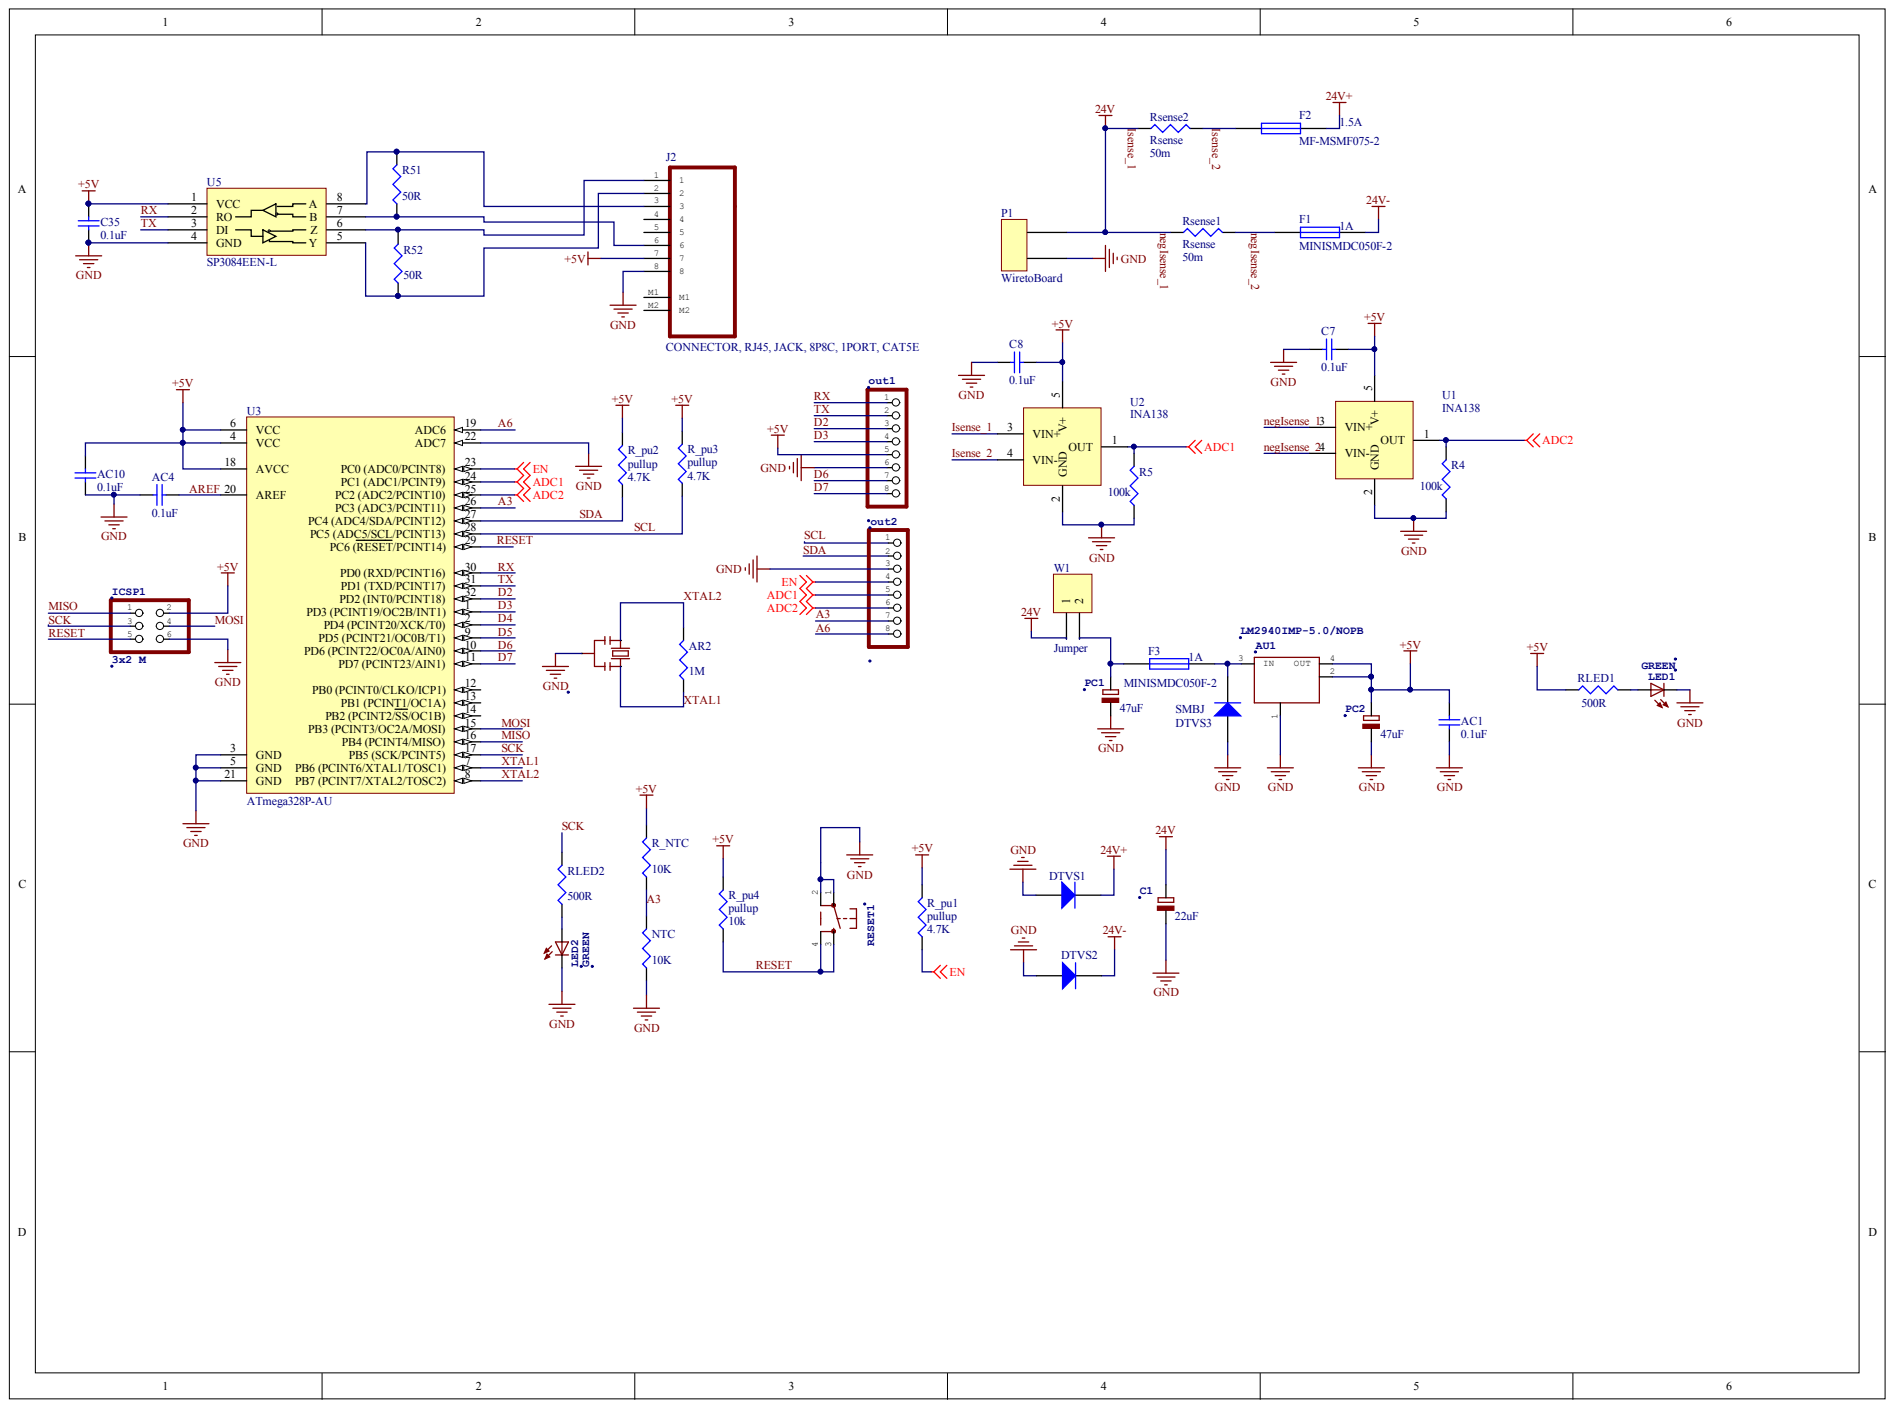
[picture p21: page 2]

2 1

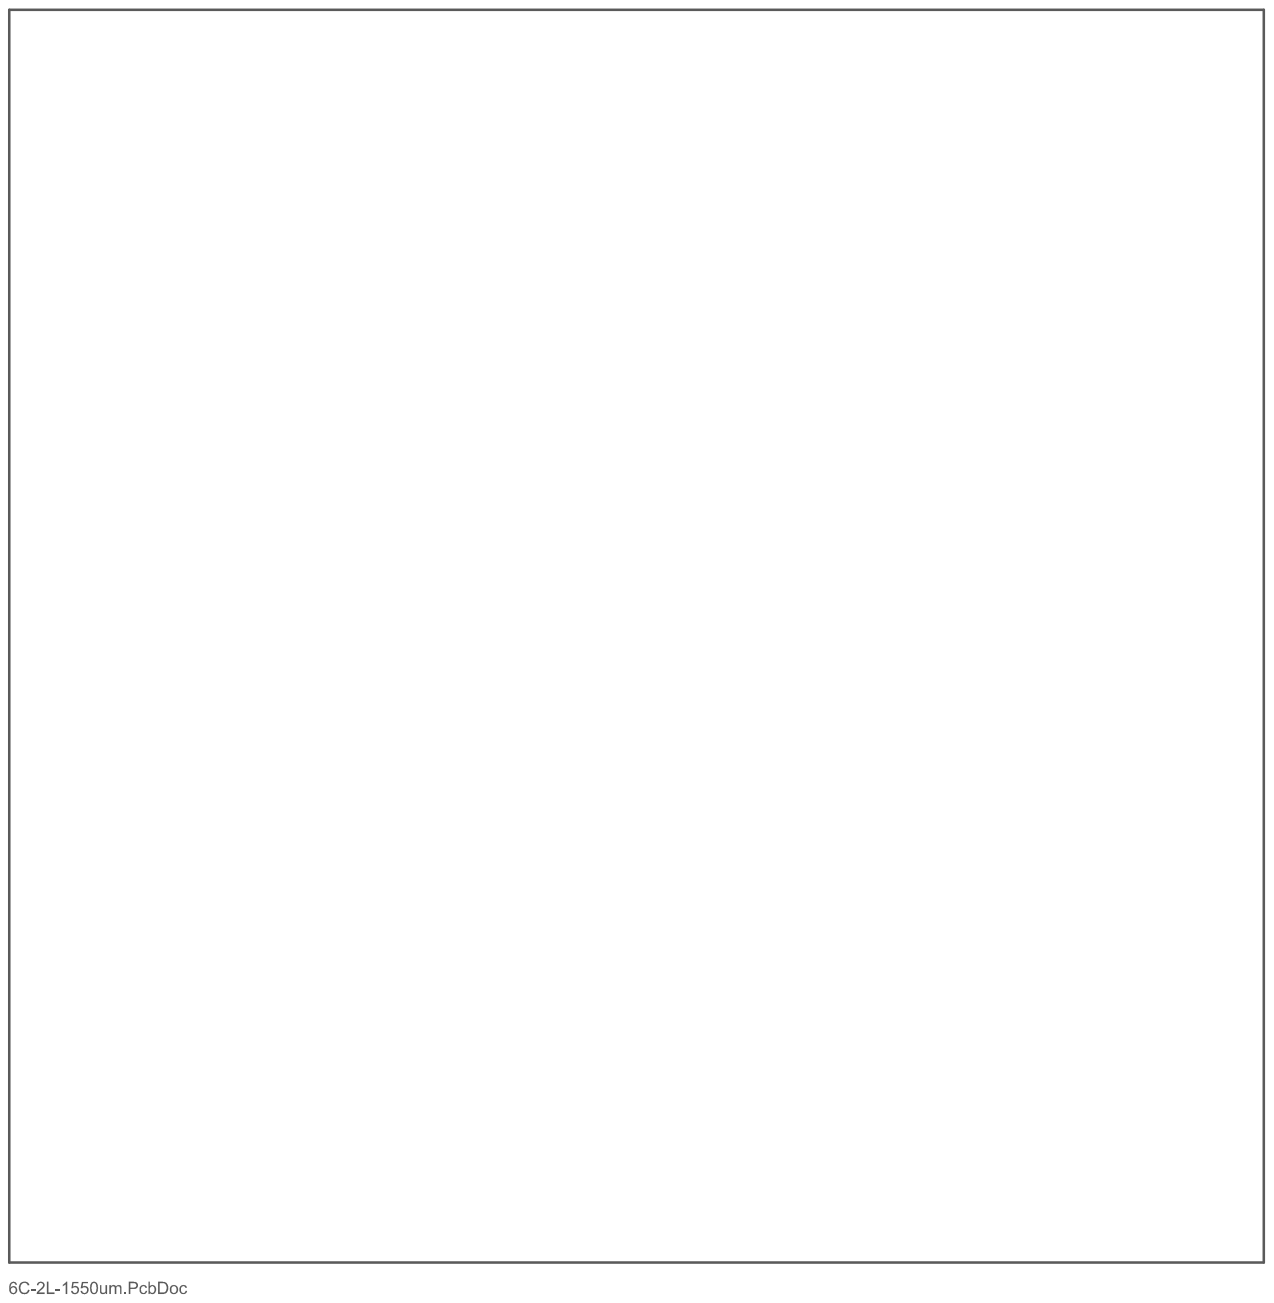
[picture p22: page 3]

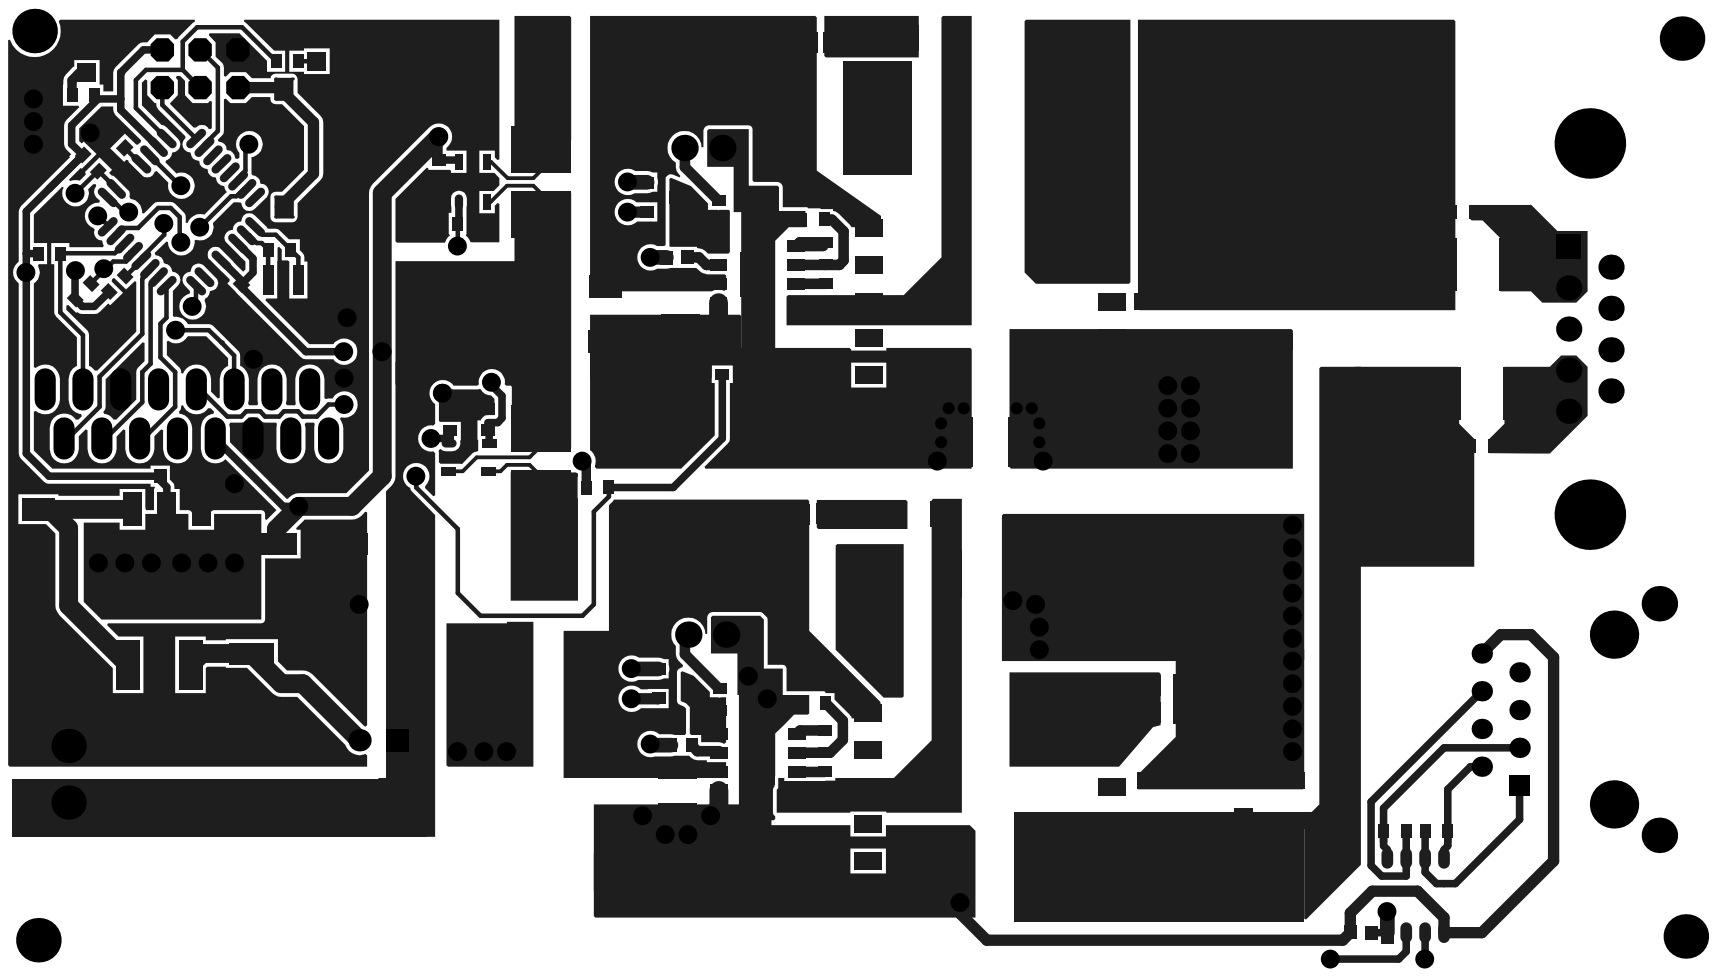
[picture p23: page 4]
