smkilani/G-2/(list of files, drawings)

Other design files:
LV_load/LV_load.PrjPcb
LV_load/PCB1.PcbDoc
LV_load/Sheet1.SchDoc
LVBackplane/Backplane.PcbDoc
LVBackplane/Backplane.SchDoc
LVBackplane/backplanelib.PcbLib
LVBackplane/BACKPLANElib.SchLib
LVBackplane/BackplanePCB.PcbDoc
LVBackplane/Connectors.SchDoc
LVBackplane/LVBackplane.PrjPcb
PCB - MasterController/LVMasterController/Eurocard VME 3U (3.937 x 8.660 inches).PCBDOC
PCB - MasterController/LVMasterController/Eurocard VME 3U (3.937 x 8.660 inches).schdoc
PCB - MasterController/LVMasterController/LVMasterController.PrjPcb
PCB - Rack 2/Backup_supplies.SchDoc
PCB - Rack 2/G2_LV.PrjPcb
PCB - Rack 2/LV1.PCBDOC
PCB - Rack 2/LV1_2.PCBDOC
PCB - Rack 2/Top.SchDoc
PCB - Rack/6C-2L-1550um.PcbDoc
PCB - Rack/controller.SchDoc
PCB - Rack/G2_LV.PrjPcb
PCB - Rack/LV1.PCBDOC
PCB - Rack/LV1.schdoc
PCB - Rack/LV1_3U.PCBDOC
PCB - Rack/LV2.PcbDoc
PCB - Rack/LV2.schdoc
PCB - Rack/Top.SchDoc
PCB - Standalone/6C-2L-1550um.PcbDoc
PCB - Standalone/controller.SchDoc
PCB - Standalone/G2_LV.PrjPcb
PCB - Standalone/G2_LV.SCHLIB
PCB - Standalone/LV1.PCBDOC
PCB - Standalone/LV1.PcbLib
PCB - Standalone/LV1.schdoc
PCB - Standalone/LV1_3U.PCBDOC
Thermostat/PCB1.PcbDoc
Thermostat/PcbLib1.PcbLib
Thermostat/Schlib1.SchLib
Thermostat/Sheet1.SchDoc
Thermostat/Thermostat.PrjPcb
