smkilani/G-2/Firmware/ATMEGA2560/masterv2/masterv2.ino

//LV Master reader/writer
//Author: Samer Kilani
//Crate version
//09/02/2016

#include <Wire.h>

//---------------- IMPORTANT ----------------------------//
//Wire.h library needs to be modified
//in Wire.h #define BUFFER_LENGTH 32 >>> #define BUFFER_LENGTH 64
//in twi.h   #define TWI_BUFFER_LENGTH 32 >>>   #define TWI_BUFFER_LENGTH 64
//The above two lines increase the i2c buffer from 32bytes to 64bytes (which matches the serial buffer size)
//in twi.h   #define TWI_FREQ 100000L >>>   #define TWI_FREQ 400000L.
//The above line increases the frequency of i2c from 100kHz to 400kHz.
//---------------- IMPORTANT ----------------------------//

#include <math.h>
#include "commands.h"
//#include <avr/pgmspace.h>

#define ver "2.0"
#define packetsize 64
#define SCidle 0x0
#define SCAmode 0x1
#define SCBmode 0x2
#define BRDSCAmode 0x3
#define BRDSCBmode 0x4

String wireString="";

#define THERMISTORNOMINAL 10000   
// temp. for nominal resistance (almost always 25 C)
#define TEMPERATURENOMINAL 25   
// The beta coefficient of the thermistor (usually 3000-4000)
#define BCOEFFICIENT 3428
// the value of the 'other' resistor
#define SERIESRESISTOR 9990 



char inputString[packetsize];  

//const char MEM_adrs_rsp[] PROGMEM  = {"Enter LV board address"};

//const PROGMEM  String menu[6]  = {"on\r","off\r","status\r","sc\r","version\r","help\r"};

String menu[11] = {"ona","onb","offa","offb","status","sca","scb","brdsca","brdscb","version","help"};
//String adrs_rsp = "Enter LV board address";
String reply[2] = {"OK","Error"};
int selected_menu=-1;
int arg=0;
int sc_mode = SCidle; 
int brdcst_size=0;
int brdcst_count=0;
char i2cpacket[packetsize]; //defined by the serial and wire buffer sizes
bool stringComplete = false;  // whether the string is complete
byte x=0;
int pointer=0;

int SCApin=44;
int SCBpin=45;
int BRDCSTApin=42;
int BRDCSTBpin=43;
int muxAdrs0=47;
int muxAdrs1=48;
int muxAdrs2=49;


void setup()
{
  Wire.begin(1); // join i2c bus (address optional for master but it is assigned as 1 to allow slaves to send back data when they receive it through the SC)
  //Wire.setClock(400000L); //setting the i2c to run at 400kHz

  for( int i = 0; i < packetsize;  ++i )
  i2cpacket[i] = (char)0;  

  Serial.begin(115200);  // start serial for menu
  Serial1.begin(125000); // start serial for SC
  //delay(1000);
  Serial.print('>');
  
  
  //pinMode(11, OUTPUT); 
  pinMode(SCApin, OUTPUT); 
  pinMode(SCBpin, OUTPUT); 
  pinMode(BRDCSTApin, OUTPUT); 
  pinMode(BRDCSTBpin, OUTPUT);   
  //pinMode(10, OUTPUT); 
  pinMode(muxAdrs0, OUTPUT); 
  pinMode(muxAdrs1, OUTPUT); 
  pinMode(muxAdrs2, OUTPUT); 
  
  digitalWrite(muxAdrs0, LOW);
  digitalWrite(muxAdrs1, LOW);
  digitalWrite(muxAdrs2, LOW);
  
  digitalWrite(SCApin,HIGH); 
  digitalWrite(SCBpin,HIGH); 
  digitalWrite(BRDCSTApin,HIGH); 
  digitalWrite(BRDCSTBpin,HIGH);   
  //digitalWrite(11,HIGH); //disable SCb mux
  //digitalWrite(10,HIGH); //disable SCb mux
}


void loop(){}

void runCMD(){
  //if (stringComplete) {
  if (pointer>1) { //to check if the command is not empty
  //Serial.println(inputString);
  
  //for (int i=0; i<packetsize;i++) Serial.println((byte)inputString[i]);
      selected_menu=-1;
      for (int i=0;i<11;i++){
        if (((String)inputString).startsWith(menu[i])) selected_menu=i;
      }
      arg=((String)inputString).substring((menu[selected_menu].length())+1,((String)inputString).length()).toInt();
	  
      //Serial.println(arg);
      //Serial.println( menu[0]);



      switch (selected_menu){
        case 0:
          Wire.beginTransmission(arg); // transmit to device #
          Wire.write(CMD_ONA);              // sends one byte
          if (Wire.endTransmission()==0) Serial.println(reply[0]);  // stop transmitting
          else Serial.println(reply[1]);
        break;
        case 1:
          Wire.beginTransmission(arg); // transmit to device #
          Wire.write(CMD_ONB);              // sends one byte
          if (Wire.endTransmission()==0) Serial.println(reply[0]);  // stop transmitting
          else Serial.println(reply[1]);
        break;
        case 2:
          Wire.beginTransmission(arg); // transmit to device #
          Wire.write(CMD_OFFA);              // sends one byte
          if (Wire.endTransmission()==0) Serial.println(reply[0]);  // stop transmitting
          else Serial.println(reply[1]);
        break;
        case 3:
          Wire.beginTransmission(arg); // transmit to device #
          Wire.write(CMD_OFFB);              // sends one byte
          if (Wire.endTransmission()==0) Serial.println(reply[0]);  // stop transmitting
          else Serial.println(reply[1]);
        break;
        case 4:
        {
            byte datain[12];
            int j=0;
            
            if (Wire.requestFrom(arg, 12)<12) Serial.println("Error");    // request 3 byte from slave device #
            else {
              delay(100);
              while (Wire.available())   // slave may send less than requested
              {
                datain[j] = Wire.read(); // receive a byte as character
                //Serial.println(datain[j],HEX);
                //Serial.print("Byte ");
               // Serial.print(i);
                //Serial.print(" ");
                //Serial.println(datain[i]);         // print the character
                j++;
              }
               
              int pinvalue1 = joinbytes(datain[0],datain[1]);
              int pinvalue2 = joinbytes(datain[2],datain[3]);
              int pinvalue3 = joinbytes(datain[4],datain[5]);
              int pinvalue4 = joinbytes(datain[6],datain[7]);
              int pinvalue5 = joinbytes(datain[8],datain[9]);
             
              float r_ntc=0.0;



                Serial.println("LV A");
                if ((datain[10]) == 0xaa) Serial.println("ON");
                else if ((datain[10]) == 0xcc) Serial.println("OFF");
                Serial.print("+5V : ");
                Serial.print(5.0*((float)pinvalue1/1023));
                Serial.println("A");
                //int pinvalue2 = ((datain[1]<<8) & 0x300) | datain[2];
                Serial.print("-5V : ");
                Serial.print(5.0*((float)pinvalue2/1023));
                Serial.println("A");
                
                Serial.println("LV B");
                if ((datain[11]) == 0xaa) Serial.println("ON");
                else if ((datain[11]) == 0xcc) Serial.println("OFF");
                Serial.print("+5V : ");
                Serial.print(5.0*((float)pinvalue3/1023));
                Serial.println("A");
                //int pinvalue2 = ((datain[1]<<8) & 0x300) | datain[2];
                Serial.print("-5V : ");
                Serial.print(5.0*((float)pinvalue4/1023));
                Serial.println("A");
                
                Serial.print("Temp : ");
                r_ntc=(1023.0/(float)pinvalue5);
                r_ntc=10000.0*(r_ntc-1.0);
                float steinhart;
                steinhart = r_ntc / THERMISTORNOMINAL;     // (R/Ro)
                steinhart = log(steinhart);                  // ln(R/Ro)
                steinhart /= BCOEFFICIENT;                   // 1/B * ln(R/Ro)
                steinhart += 1.0 / (TEMPERATURENOMINAL + 273.15); // + (1/To)
                steinhart = 1.0 / steinhart;                 // Invert
                steinhart -= 273.15;                         // convert to C
            
                //temp=(temp*10000.0)/(1.0-temp);
                //temp=(temp*10000.0)/(1.0-temp);
                //temp=(BCOEFFICIENT/log(temp/0.102756))-273.15;
                //Serial.print(pinvalue3);
                Serial.print(steinhart);
                Serial.println("C");
              }
        
        
        }
        break;
        case 5:
        
            Wire.beginTransmission(arg); // transmit to device #
            Wire.write(CMD_SCA_ON);              // sends one byte
            if (Wire.endTransmission()==0) {
              Serial.println(reply[0]);  // stop transmitting
              digitalWrite(SCApin,HIGH); 
              digitalWrite(SCBpin,HIGH); 
              digitalWrite(BRDCSTApin,HIGH); 
              digitalWrite(BRDCSTBpin,HIGH);  
              set_mux_adrs(arg);
              digitalWrite(SCApin,LOW); //enable SC mux
              //digitalWrite(10,LOW); //LED
              sc_mode=SCAmode;    
            }
            else Serial.println(reply[1]);
        break;
        case 6:
            Wire.beginTransmission(arg); // transmit to device #
            Wire.write(CMD_SCB_ON);              // sends one byte
            if (Wire.endTransmission()==0) {
              Serial.println(reply[0]);  // stop transmitting
              digitalWrite(SCApin,HIGH); 
              digitalWrite(SCBpin,HIGH); 
              digitalWrite(BRDCSTApin,HIGH); 
              digitalWrite(BRDCSTBpin,HIGH);  
              set_mux_adrs(arg);
              digitalWrite(SCBpin,LOW);
            
              sc_mode=SCBmode;    // stop transmitting
            }
            else Serial.println(reply[1]);
            
            break;
	case 7:
              digitalWrite(SCApin,HIGH); 
              digitalWrite(SCBpin,HIGH); 
              digitalWrite(BRDCSTApin,LOW); 
              digitalWrite(BRDCSTBpin,HIGH);  
            
	    brdcst_size=arg;
	    brdcst_count=0;
            sc_mode=BRDSCAmode;   

        break;
	case 8:
              digitalWrite(SCApin,HIGH); 
              digitalWrite(SCBpin,HIGH); 
              digitalWrite(BRDCSTApin,HIGH); 
              digitalWrite(BRDCSTBpin,LOW);  
	    brdcst_size=arg;
            brdcst_count=0;
            sc_mode=BRDSCBmode;  
        break;
        case 9:
        Serial.println(ver);
        break;
        case 10:
        for (int i = 0;i<11;i++) Serial.println(menu[i]);
        break;
        default:
        for (int i = 0;i<11;i++) Serial.println(menu[i]);
        Serial.println("Bad command");   
      }

    }
    
    
    
    // clear the string:
    for( int i = 0; i < packetsize;  ++i )
    inputString[i] = (char)0;
    pointer=0;
    //stringComplete = false;
    if (sc_mode==SCidle) Serial.print('>');
  //}
}

/*void WireEvent(int numBytes) {
  
	if (sc_mode==1){	
	//Serial.println("testtt");
  	  while (Wire.available()) {  // slave may send less than requested
            char c = Wire.read(); // receive a byte as character
            if (c<=0) break;
            Serial.print(c);
          }
	}
}*/



void serialEvent1() {
    while (Serial1.available()) {
      char inChar = (char)Serial1.read();
      //Serial.write("Receiving");
      Serial.write(inChar);
    }
}
void serialEvent() {
  int scpointer=0;
  while (Serial.available()) {
    char inChar = (char)Serial.read();
    if (sc_mode==SCAmode || sc_mode==SCBmode)
    {
      if (inChar!=0x03){
        //Serial1.println("help");
        Serial1.write(inChar);
      }
      else{
        //break @ CTRL+C
        Wire.beginTransmission(arg); // transmit to device #
        if (sc_mode==SCAmode) Wire.write(CMD_SCA_OFF); else if (sc_mode==SCBmode) Wire.write(CMD_SCB_OFF);              // sends one byte
        if (Wire.endTransmission()==0) Serial.println(reply[0]); else Serial.println(reply[1]); // stop transmitting
          
        sc_mode=SCidle;
        digitalWrite(SCApin,HIGH); 
        digitalWrite(SCBpin,HIGH); 
        digitalWrite(BRDCSTApin,HIGH); 
        digitalWrite(BRDCSTBpin,HIGH);  

        Serial.print("SC mode ended\n>");
      }
    }else if ((sc_mode==BRDSCAmode) || (sc_mode==BRDSCBmode)){
      if (brdcst_count<brdcst_size)
      {
        Serial1.write(inChar);
        brdcst_count++;
      }else{
        Wire.beginTransmission(0); // transmit to device #
        //if (sc_mode==SCAmode) Wire.write(CMD_SCA_OFF); else if (sc_mode==SCBmode) Wire.write(CMD_SCB_OFF);              // sends one byte
        Wire.write(CMD_SCA_OFF);
        Wire.write(CMD_SCB_OFF);
        if (Wire.endTransmission()==0) Serial.println(reply[0]); else Serial.println(reply[1]);  // stop transmitting
          
        sc_mode=SCidle;
  	brdcst_count=0;  
        digitalWrite(SCApin,HIGH); 
        digitalWrite(SCBpin,HIGH); 
        digitalWrite(BRDCSTApin,HIGH); 
        digitalWrite(BRDCSTBpin,HIGH);  
        
      
      }
    } else {
      //Serial.print((byte)inChar);
      inputString[pointer] = inChar;
      if ((inChar==0x7F | inChar==0x8) & pointer>0) { //backspace or delete
        Serial.write(inChar); 
        inputString[pointer] = (char)0;
        pointer--; 
      }
      else {
        Serial.write(inChar); 
        if (pointer<packetsize) pointer++;
      }
      if (inChar == '\r') runCMD();		
    }
  }
}


int joinbytes(byte b1, byte b2)
{
  int joinedint = ((b2<<8) & 0x0f00) | (0xff & b1);
  return joinedint;
}

int set_mux_adrs(int adrs)
{
  /*
  C   B   A     Out
  D49 D48 D47
  0   0   0     0
  0   0   1     1
  0   1   0     2
  0   1   1     3
  1   0   0     4
  1   0   1     5
  1   1   0     6
  1   1   1     7
  
  However
  
  When making the PCB the pinout order was overlooked. The actual pin map is
  
  TX1 and RX1 --> 4
  TX2 and RX2 --> 6
  TX3 and RX3 --> 3
  TX4 and RX4 --> 0
  TX5 and RX5 --> 1
  TX6 and RX6 --> 2
  TX7 and RX7 --> 7
  TX8 and RX8 --> 5
  */
  
  bool a,b,c;
  switch (adrs){
    case 5://4
      a=LOW;
      b=LOW;
      c=LOW;
    break;
    case 6://5
      a=HIGH;
      b=LOW;
      c=LOW;
    break;
    case 7://6
      a=LOW;
      b=HIGH;
      c=LOW;
    break;
    case 4://3
      a=HIGH;
      b=HIGH;
      c=LOW;
    break;
    case 2://1
      a=LOW;
      b=LOW;
      c=HIGH;
    break;
    case 9://8
      a=HIGH;
      b=LOW;
      c=HIGH;
    break;
    case 3://2
      a=LOW;
      b=HIGH;
      c=HIGH;
    break;
    case 8://7
      a=HIGH;
      b=HIGH;
      c=HIGH;
    break;
    default:
      a=LOW;
      b=LOW;
      c=LOW;
    break;
  }

  digitalWrite(muxAdrs2, c);
  digitalWrite(muxAdrs1, b);
  digitalWrite(muxAdrs0, a);
}
