smkilani/G-2/Firmware/ATMEGA2560/masterv2/commands.h

#define CMD_ONA 0x1
#define CMD_ONB 0x2
#define CMD_OFFA 0x3
#define CMD_OFFB 0x4
#define CMD_statusA 0x5
#define CMD_statusB 0x6
#define CMD_SCA_ON 0x9
#define CMD_SCA_OFF 0xA
#define CMD_SCB_ON 0x7
#define CMD_SCB_OFF 0x8
#define CMD_BRDSCA 0xB
#define CMD_BRDSCB 0xC
