smkilani/G-2/(commit log)

2015-05-08 Added PCB and firmware
    [6C-2L-1550um.PcbDoc, G2_LV.PrjPcb, G2_LV.SCHLIB, LV1.PCBDOC, LV1.PcbLib, LV1.schdoc, controller.SchDoc]
2015-05-08 Created Gerber files
    [G2_LV.PrjPcb, LV1.PCBDOC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]
2015-05-11 RJ45 added
    [G2_LV.SCHLIB, LV1.PCBDOC, LV1.PcbLib, controller.SchDoc]
2015-05-11 RJ45 layout progress
    [LV1.PCBDOC]
2015-05-12 New Gerber and routed RS422
    [G2_LV.SCHLIB, LV1.PCBDOC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]
2015-05-12 Gerber fixed
    [LV1.PCBDOC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]
2015-05-12 saved project
    [G2_LV.PrjPcb]
2015-05-13 Minor layout fixes
    [LV1.PCBDOC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]
2015-05-15 BOM added
    [BOM.csv, BOM.xls, G2_LV.PrjPcb, LV1.schdoc, controller.SchDoc]
2015-05-29 Firmware update for Rev 2.0 boards
2015-06-02 Undervoltage fix
    [LV1.schdoc]
2015-06-05 Current sense fix
2015-06-19 3D backplane design and new rack PCB design
    [172-009-212.ipt, 24563131.0002.iam, 24563131.iam, 24563131_01.ipt, 24563131_02.ipt, 24563131_03.ipt, 24563131_04.ipt, 24563131_05.ipt]
2015-06-23 Modified backplane
    [10046971004lf.0001.ipt, 10046971004lf.ipt, 10046971004lf.stp, 172-009-212.0001.ipt, 172-009-212.0002.ipt, 172-009-212.ipt, 24563131.0002.iam, 24563131.0005.iam]
2015-06-29 Many updates
    [172-009-212.0001.ipt, 172-009-212.ipt, 424108312.0001.iam, 424108312.iam, 574386272.0001.iam, 574386272.iam, 574386432.0001.iam, 574386432.iam]
2015-07-01 updates on LV PCB RACK
    [G2_LV.SCHLIB, LV1.PCBDOC, LV1.PcbLib, Top.SchDoc, controller.SchDoc]
2015-07-02 LV PCB Rack updates
    [G2_LV.SCHLIB, LV1.PCBDOC, LV1.PcbLib, Top.SchDoc, controller.SchDoc]
2015-07-06 PCB updates
    [LV1.PCBDOC, controller.SchDoc]
2015-07-07 PCB LV Rack Rev 1.0
    Rev 1.0 for LV PCB Rack
    [G2_LV.SCHLIB, LV1.PCBDOC, LV1.PcbLib, controller.SchDoc]
2015-07-07 Added extra line for ADRS
    [Backplane.SchDoc, LV1.PCBDOC, Top.SchDoc, controller.SchDoc]
2015-07-10 Rack updates
    [LV1.PCBDOC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]
2015-08-24 New layout
    The edge connector is removed and replace with a standard DIN41612
    connector. This required the board to be longer. From 160mm to 220mm.
    [BACKPLANElib.SchLib, G2_LV.SCHLIB, LV1.PCBDOC, LV1.PcbLib, Top.SchDoc, backplanelib.PcbLib]
2015-08-25 LV Rack design 1.0
    First verion of the Rack LV board is finished. Mini backplane design has
    started
    [Backplane.PcbDoc, Backplane.SchDoc, Connectors.SchDoc, G2_LV.PrjPcb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]
2015-08-26 Modifications to LV Rack and backplane boards
    Added power entry to backplane and other mods
    [BACKPLANElib.SchLib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]
2015-08-27 Final updates for V1.0
    Updates were made for the first batch of PCBs. Order sent today.
    [G2_LV.SCHLIB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]
2015-09-01 Fixed ADRS lines
    The ADRS lines are now pulled-up. The ADRS pins on the backplane should
    now either be GND or Floating.
    [LV1.PCBDOC, Top.SchDoc]
2015-09-05 BOM generated
    [BOM2.xls, G2_LV.PrjPcb, LV1.PCBDOC, Top.SchDoc, controller.SchDoc]
2015-09-11 Fixed hole sizes for the DIN connectors
    [BOM2.xls, Backplane.PcbDoc, LV1.PCBDOC, LV1.PcbLib, backplanelib.PcbLib, controller.SchDoc]
2015-09-30 new firmware and other
    [Backplane.SchDoc, LV1.PCBDOC]
2015-09-30 fixed slow control
    added 5V and GND to SC
    [Connectors.SchDoc, LV1.PCBDOC]
2015-10-07 Firmware and backplane updates
    [BACKPLANElib.SchLib, Backplane.PcbDoc, Backplane.SchDoc, Connectors.SchDoc, G2_LV.SCHLIB, LV1.PCBDOC, LV1.PcbLib, controller.SchDoc]
2015-11-18 Rev. 2.0 of Rack board
    The +5V supplies where replaced with higgher power circuitry. now the
    positive channel is capable of supplying >30W.
    [Backplane.PcbDoc, G2_LV.PrjPcb, G2_LV.SCHLIB, LV1.PCBDOC, LV1.PcbLib, LV1.schdoc, LV2.PcbDoc, LV2.schdoc]
2015-11-18 Minor fixes to Rev 2.0
    [LV1.PCBDOC]
2015-11-19 Updated Backplane
    1) Added USB connection to backplane and routed all the tracks
    2) Moved the LEDs on the LV card to align with the frontpanel
    [BACKPLANElib.SchLib, Backplane.PcbDoc, Backplane.SchDoc, Connectors.SchDoc, LV1.PCBDOC, backplanelib.PcbLib]
2015-11-19 Gerber files generated
    [Backplane.PcbDoc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]
2015-11-19 Gerber fixes
    [G2_LV.PrjPcb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]
2015-11-27 Release 2.
    Gerber files has been generated and sent to Eurocircuit.
    [Backplane.PcbDoc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]
2015-12-03 removed unconnected track
    [BOM.xls, Backplane.SchDoc, Connectors.SchDoc, G2_LV.PrjPcb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]
2015-12-10 Changes to the LV Rack PCB and backplane
    - The backplane was changed to match the output of the Rack PCB (missing
    from the latest PCB v2.0)
    - The LV schematic has some incorrect net names which were corrected.
    PCB layout also fixed
    - Firmware also changed to accommodate the EN pin change for v2.0
    [Backplane.PcbDoc, Connectors.SchDoc, G2_LV.PrjPcb, G2_LV.xlsx, LV1.PCBDOC, LV2.schdoc, Top.SchDoc]
2016-01-19 Minor changes
    [Eurocard VME 3U (3.937 x 8.660 inches).PCBDOC, Eurocard VME 3U (3.937 x 8.660 inches).schdoc, G2_LV.PrjPcb, LV1.PCBDOC, LV1.PcbLib, LV1.schdoc, LV2.schdoc, LVMasterController.PrjPcb]
2016-01-29 Reducing ripple
    [LV1.PCBDOC, LV2.schdoc]
2016-02-01 Improved grounding
    [LV1.PCBDOC]
2016-02-01 Minor update
    [LV1.PCBDOC]
2016-02-05 Backplane RS422 RX TX fix
    [Connectors.SchDoc]
2016-02-06 Added event based i2c comm
2016-02-08 Added wire handler
2016-02-09 fixing i2c buffer
2016-02-09 Fixed I2C buffer sizes
    This update also included library files. The code refers to the
    libraries in the arduino library directory which they should either be
    overwritten with these files or amend the following:
    in Wire.h #define BUFFER_LENGTH 32 >>> #define BUFFER_LENGTH 64
    in
    twi.h #define TWI_BUFFER_LENGTH 32 >>> #define TWI_BUFFER_LENGTH
    64
    The above two lines increase the i2c buffer from 32bytes to 64bytes
    (which matches the serial buffer size)
    in twi.h #define TWI_FREQ
    100000L >>> #define TWI_FREQ 400000L.
    The above line increases the
    frequency of i2c from 100kHz to 400kHz.
    [master.ino, slave.ino]
2016-02-09 improved i2c packeting
2016-02-12 PCB and Firmware improvements
    [Backplane.PcbDoc, Backplane.SchDoc, LV1.PCBDOC, Top.SchDoc, controller.SchDoc]
2016-02-15 LV Rack new rev. (beta)
    [LV1.PCBDOC, LV1.schdoc, LV2.schdoc, Top.SchDoc, controller.SchDoc]
2016-02-15 Backplane changes
    [BACKPLANElib.SchLib, Backplane.PcbDoc, Backplane.SchDoc, Connectors.SchDoc, Eurocard VME 3U (3.937 x 8.660 inches).PCBDOC, Eurocard VME 3U (3.937 x 8.660 inches).schdoc, LV1.PCBDOC, LVBackplane.PrjPcb]
2016-02-16 Backplane mods
    [Backplane.PcbDoc, Backplane.SchDoc, Connectors.SchDoc, LVBackplane.PrjPcb, Top.SchDoc]
2016-02-16 Full Backplane rev 2.0 (beta)
    [Backplane.SchDoc, LV1.PCBDOC]
2016-02-17 Controller improvements
    [Backplane.SchDoc, Connectors.SchDoc, Eurocard VME 3U (3.937 x 8.660 inches).PCBDOC, Eurocard VME 3U (3.937 x 8.660 inches).schdoc]
2016-02-18 Controller PCB
    [Eurocard VME 3U (3.937 x 8.660 inches).PCBDOC, Eurocard VME 3U (3.937 x 8.660 inches).schdoc, G2_LV.PrjPcb, LV1.PCBDOC, LV1.schdoc, LV2.schdoc, LVMasterController.PrjPcb, Top.SchDoc]
2016-02-19 More PCB fixes
    [Eurocard VME 3U (3.937 x 8.660 inches).PCBDOC, Eurocard VME 3U (3.937 x 8.660 inches).schdoc, LV1.PCBDOC, controller.SchDoc]
2016-03-09 PCB Sent
    This update includes the gerber files and boms of the latest PCBs. PCBs
    expected 15/3/2015
    [BACKPLANElib.SchLib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]
2016-03-10 bom update
    [G2_LV3.xlsx, LVMasterControllerBOM.xlsx]
2016-04-01 firmware updates
    Firmware for the new controller. The SC does not use i2c anymore. It is
    routed through buffers and mux's straight to the RS422 chip.
2016-04-08 firmware update and resistor change
    The undervoltage lock resistor changed from 500k to 370k. To allow 36V
    operation.
    [LV1.schdoc, LV2.schdoc]
2016-04-12 Major changes after PCB modifications
    [X]3) labels of the adrs resistors of the LV board are not visible
    [X]4) the NTC is on (wrong) bottom side.
    [X]5) LED labels. A is B and B is A
    [X]6) accept commands from the master controller to show SC status. This
    means the two currently GP LEDS are to be used for SC modes.
    [ ]Master controller
    [X] a) Disconnect VCCIO from XVCC and connect to 5V
    [X] b) the 27ohm should be connected to D+ and D- not tx and rx
    [X] c) 6MHz resonator required
    [X] d) TX and RX should be reversed when connected to the arduino.
    RX to TX and Tx to RX
    [X] e) the A and B Muxs must have different enable pins. Change
    Mux_en to Mux_en_a and Mux_en_b
    [X] f)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
    [Eurocard VME 3U (3.937 x 8.660 inches).PCBDOC, Eurocard VME 3U (3.937 x 8.660 inches).schdoc, LV1.PCBDOC, backplanelib.PcbLib]
2016-04-15 firmware changes
    [Eurocard VME 3U (3.937 x 8.660 inches).PCBDOC, Eurocard VME 3U (3.937 x 8.660 inches).schdoc]
2016-04-19 schematic update
    [Top.SchDoc]
2016-04-29 status command return fix
    fixed the ON/OFF status and the temperature reading
    [masterv2.ino, slavev2.ino]
2016-05-25 changed baud rate to 125000
    [Eurocard VME 3U (3.937 x 8.660 inches).GBL, Eurocard VME 3U (3.937 x 8.660 inches).GBO, Eurocard VME 3U (3.937 x 8.660 inches).GBS, Eurocard VME 3U (3.937 x 8.660 inches).GM1, Eurocard VME 3U (3.937 x 8.660 inches).GTL, Eurocard VME 3U (3.937 x 8.660 inches).GTO, Eurocard VME 3U (3.937 x 8.660 inches).GTS]
2016-06-08 some changes
    [LV2.schdoc, backplanelib.PcbLib]
2016-06-09 added 2 new layers
    [LV1.PCBDOC]
2016-06-16 modified the PCB to improve common mode noise
    [BACKPLANElib.SchLib, Backplane.SchDoc, Connectors.SchDoc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]
2016-06-29 New firmware and new LV PCB v3
    [G2_LV4.xlsx, LV1.PCBDOC, Top.SchDoc, controller.SchDoc]
2016-07-15 snubber edit
    [G2_LV.PrjPcb, LV2.schdoc, Top.SchDoc, controller.SchDoc]
2016-08-31 started new PCB.
    The new LV board will have a unified DC-DC design on all channels.
    [G2_LV.PrjPcb, LV1.PCBDOC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]
2016-09-06 New PCB
    All 4 channels in the PCB now have the same transformer and controller.
    Ready for fabrication
    [LV1.PCBDOC, Top.SchDoc]
2016-09-09 some updates
    [G2_LV.PrjPcb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]
2016-09-29 Firmware updates
    Master firmware update to work with the latest controller. Also a test
    PCB was made for loading the LV boards.
    [Backplane.SchDoc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]
2016-10-14 minor updates
    [BACKPLANElib.SchLib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]
2016-10-14 some update
    [Backplane.GBL, Backplane.GBO, Backplane.GBP, Backplane.GBS, Backplane.GM1, Backplane.GTL, Backplane.GTO, Backplane.GTS]
2016-11-03 ACDCcontroller firmware
    [BACKPLANElib.SchLib, Backplane.PcbDoc, Backplane.SchDoc, Connectors.SchDoc, G2_LV.xlsx, LV1.PCBDOC, PCB1.PcbDoc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]
2016-11-08 acdc voltage output fixed
    [ACDCcontroller.ino]
2016-11-11 some minor changes
    [Connectors.SchDoc]
2016-11-14 minor changes to controller
    [Eurocard VME 3U (3.937 x 8.660 inches).PCBDOC, Eurocard VME 3U (3.937 x 8.660 inches).schdoc, LVMasterController2.xlsx]
2016-12-01 changes to LV
    [Backplane.PcbDoc, Backplane.SchDoc, Backup_supplies.SchDoc, G2_LV.PrjPcb, LV1.PCBDOC, Top.SchDoc]
2016-12-01 LV change
    [Eurocard VME 3U (3.937 x 8.660 inches).schdoc, LV1.schdoc]
2017-05-03 A few changes.
    [Backplane.SchDoc, Connectors.SchDoc, Eurocard VME 3U (3.937 x 8.660 inches).schdoc, G2_LV.PrjPcb, G2_LV_2.xlsx, LV1.schdoc, Top.SchDoc, controller.SchDoc]
